FachriMFulchan/Arm_Manipulator_7_Functions/Dokumentasi/MainBoard_MasterController-removebg-preview.png

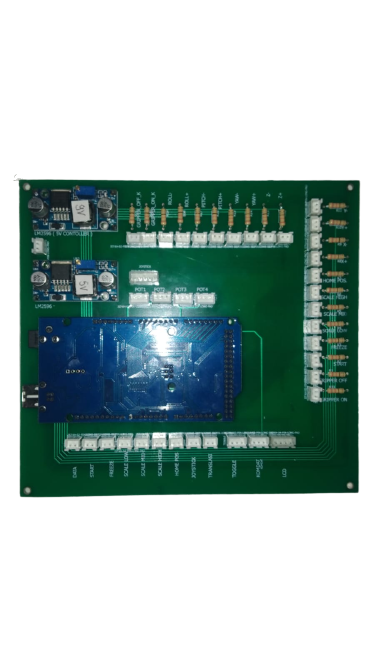
Dokumentasi/MainBoard_MasterController-removebg-preview.png
