FachriMFulchan/Arm_Manipulator_7_Functions/Master Controller/Elektrik/Skema Master Controller.jpeg

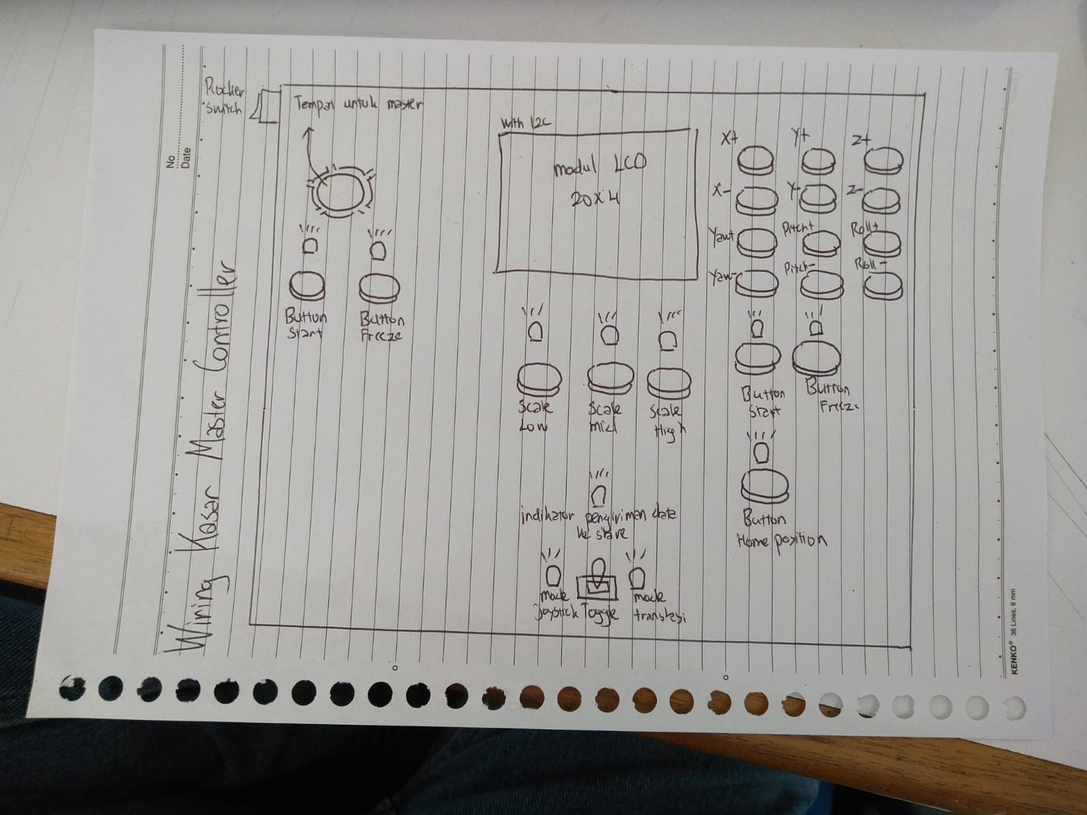
Master Controller/Elektrik/Skema Master Controller.jpeg
