FachriMFulchan/Arm_Manipulator_7_Functions/README.md

# Arm_Manipulator_7_Functions
Ini merupakan data dokumentasi dari Proyek Akhir kami yang berjudul "Rancang Bangun Arm Manipulator 7 Functions dan Master Controller" di Politeknik Manufaktur Negeri Bandung
