FachriMFulchan/Arm_Manipulator_7_Functions/Dokumentasi/driver.jpeg

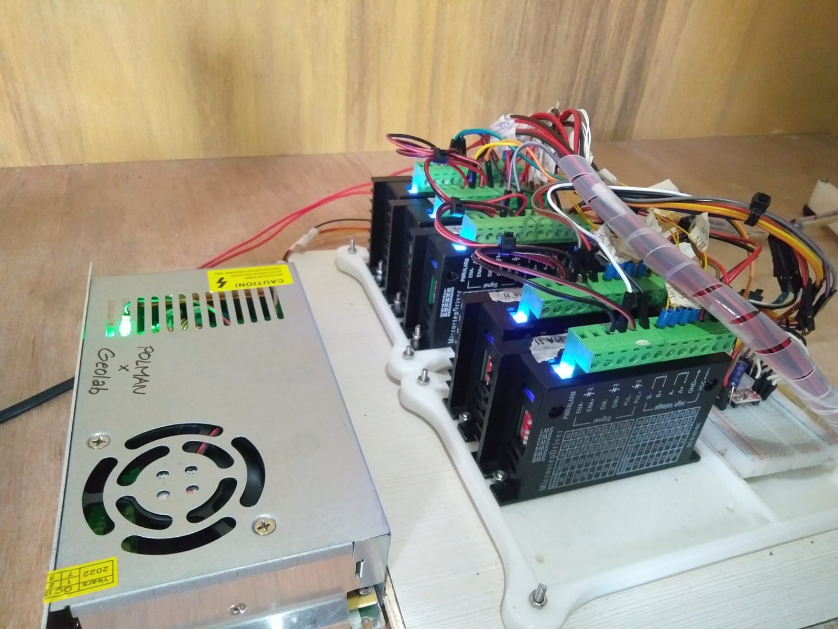
Dokumentasi/driver.jpeg
