FachriMFulchan/Arm_Manipulator_7_Functions/Dokumentasi/Joystick master 2.png

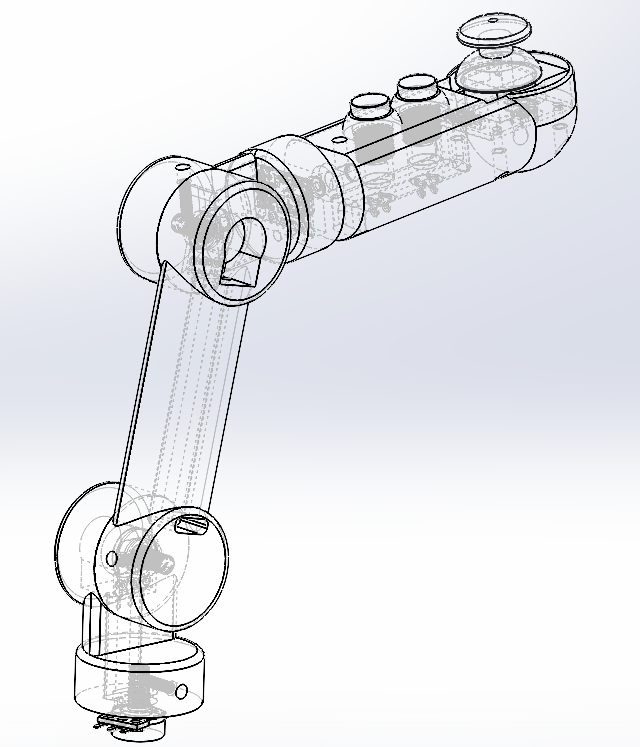
Dokumentasi/Joystick master 2.png
