FachriMFulchan/Arm_Manipulator_7_Functions/Dokumentasi/Manip.PNG

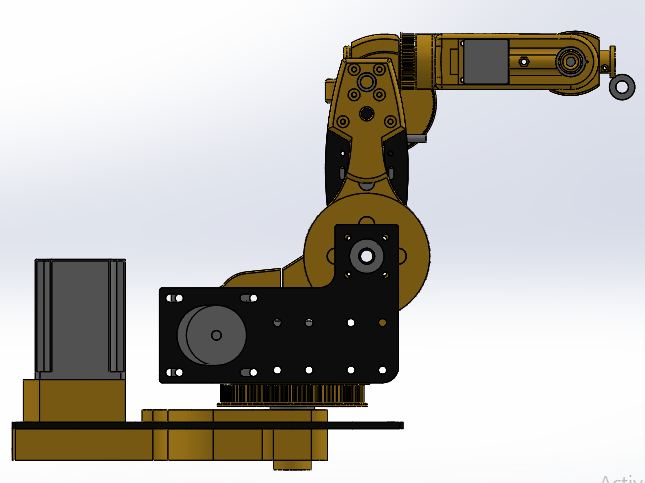
Dokumentasi/Manip.PNG
