FachriMFulchan/Arm_Manipulator_7_Functions/Dokumentasi/WhatsApp Image 2022-06-15 at 9.09.38 AM.jpeg

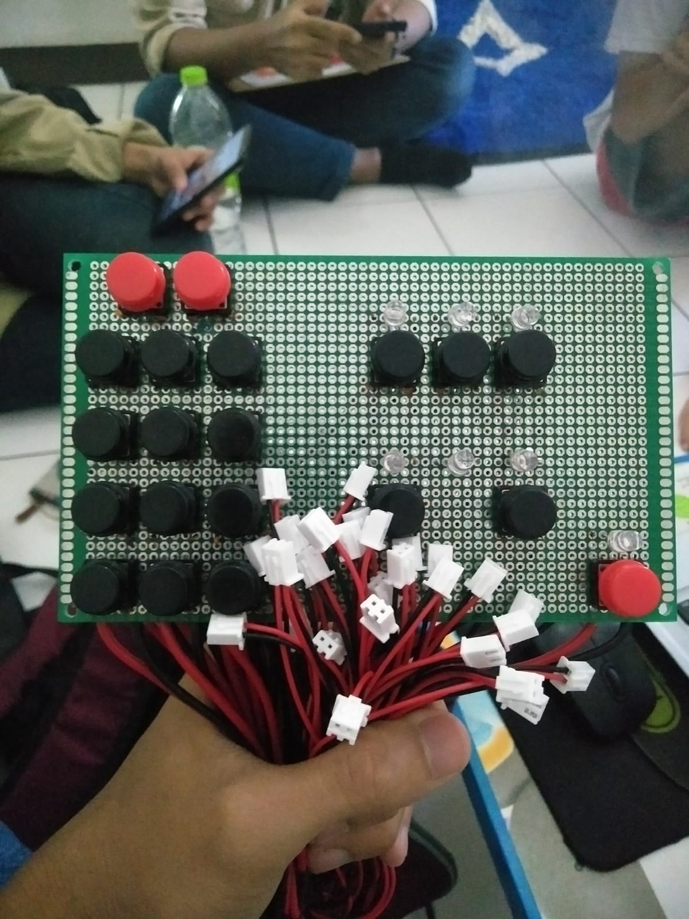
Dokumentasi/WhatsApp Image 2022-06-15 at 9.09.38 AM.jpeg
