FachriMFulchan/Arm_Manipulator_7_Functions/Dokumentasi/WhatsApp Image 2022-06-15 at 9.09.39 AM (1).jpeg

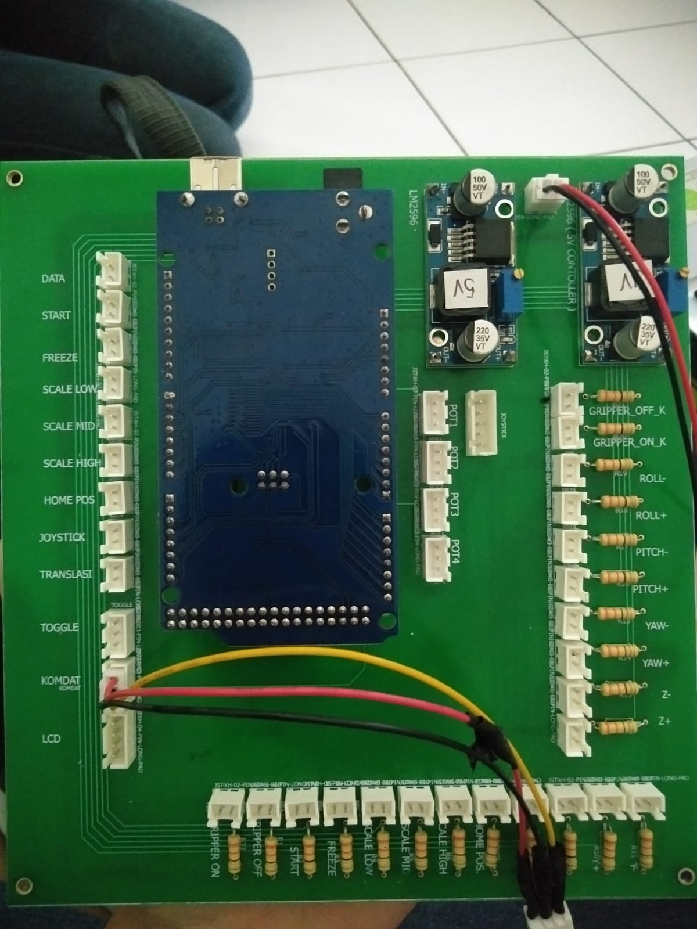
Dokumentasi/WhatsApp Image 2022-06-15 at 9.09.39 AM (1).jpeg
