FachriMFulchan/Arm_Manipulator_7_Functions/Dokumentasi/WhatsApp Image 2022-06-25 at 14.25.39.jpeg

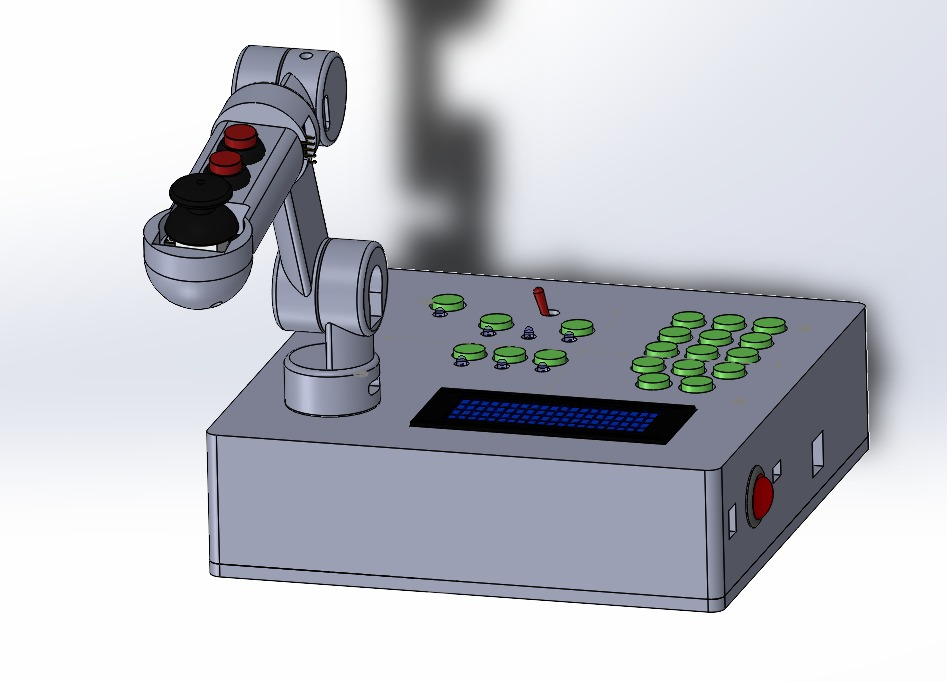
Dokumentasi/WhatsApp Image 2022-06-25 at 14.25.39.jpeg
