FachriMFulchan/Arm_Manipulator_7_Functions/Dokumentasi/WhatsApp Image 2022-07-04 at 04.54.05.jpeg

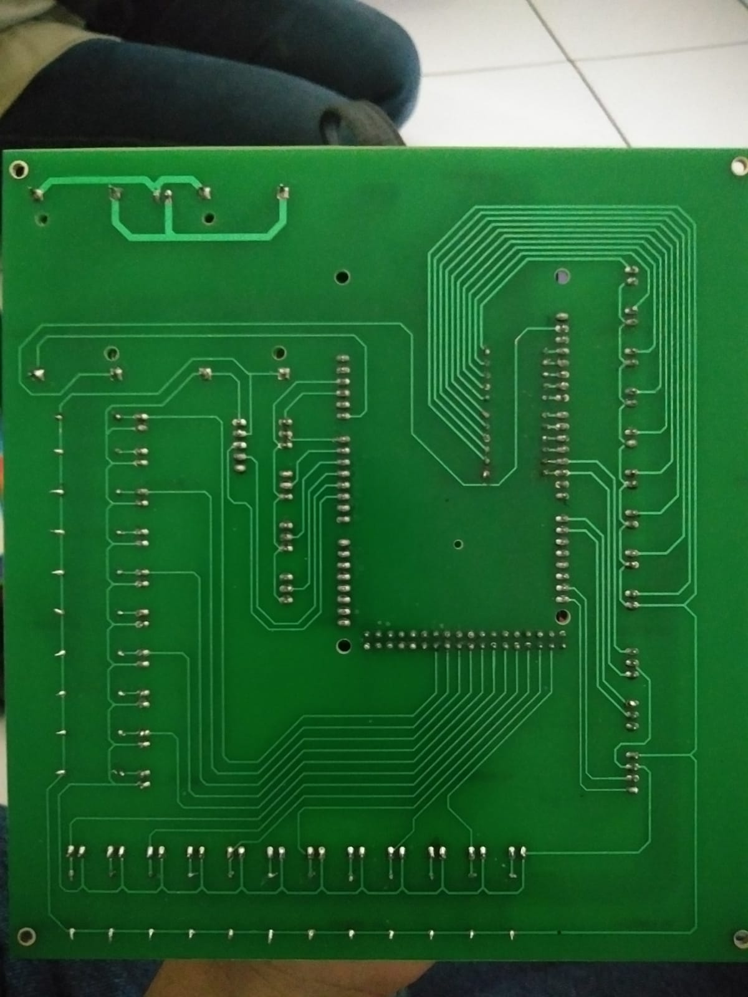
Dokumentasi/WhatsApp Image 2022-07-04 at 04.54.05.jpeg
