FachriMFulchan/Arm_Manipulator_7_Functions/Dokumentasi/WhatsApp Image 2022-07-06 at 9.26.13 AM.jpeg

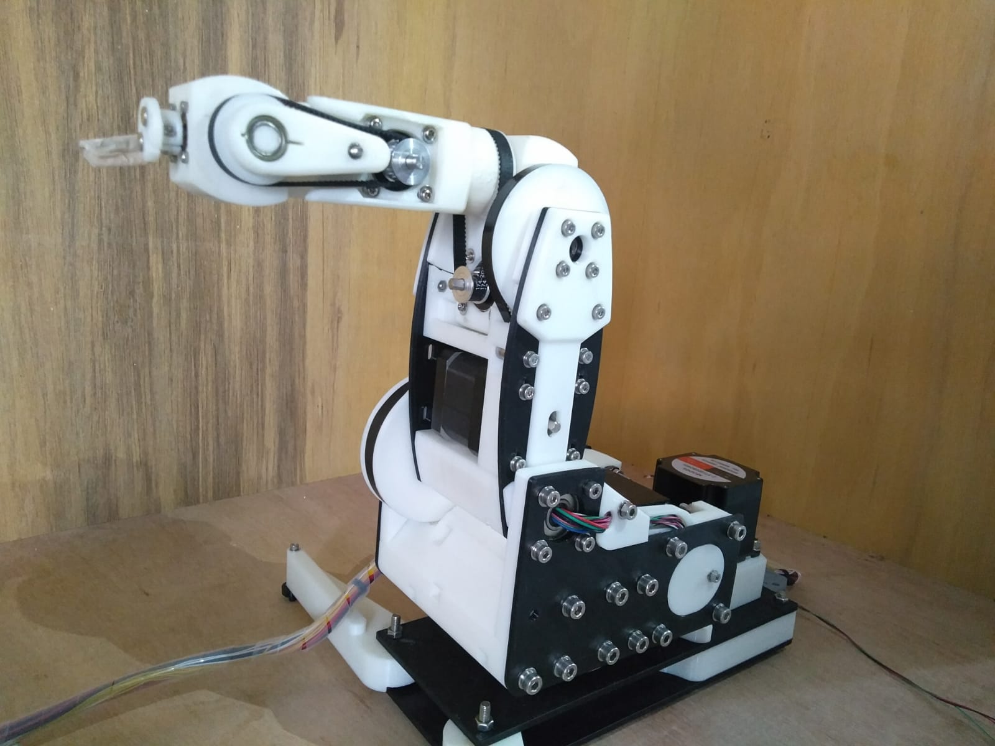
Dokumentasi/WhatsApp Image 2022-07-06 at 9.26.13 AM.jpeg
