FachriMFulchan/Arm_Manipulator_7_Functions/Dokumentasi/WhatsApp Image 2022-07-09 at 4.13.47 PM.jpeg

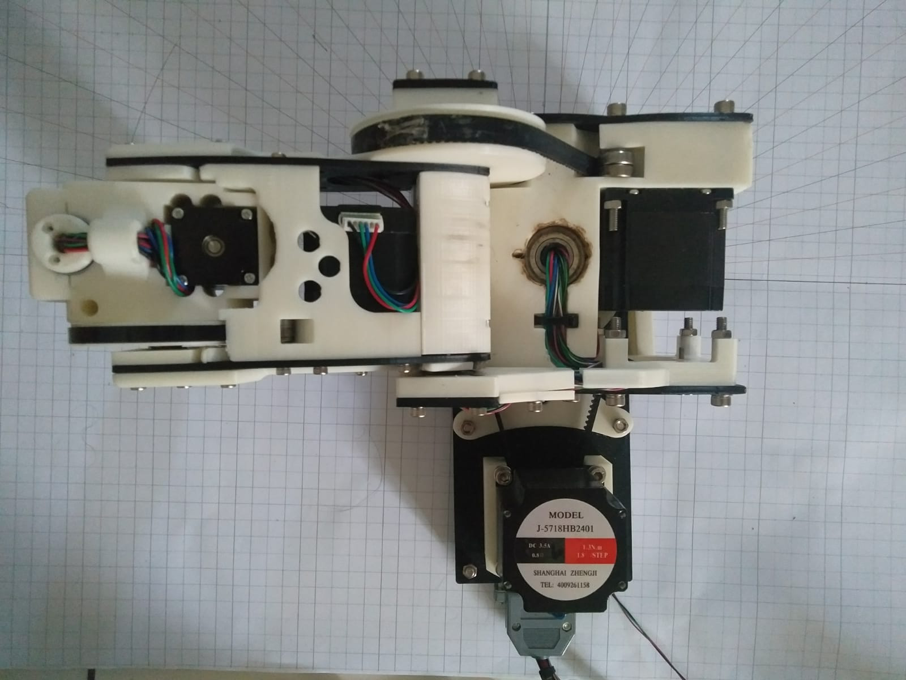
Dokumentasi/WhatsApp Image 2022-07-09 at 4.13.47 PM.jpeg
