FachriMFulchan/Arm_Manipulator_7_Functions/Dokumentasi/workspace1.PNG

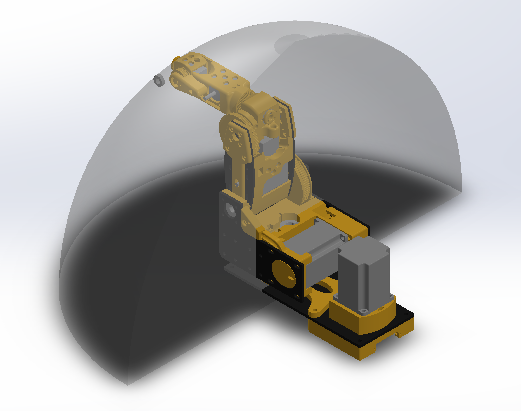
Dokumentasi/workspace1.PNG
