FachriMFulchan/Arm_Manipulator_7_Functions/Master Controller/Mekanik/SOLIDWORKS.Part/MasterV2 (40mm).SLDASM

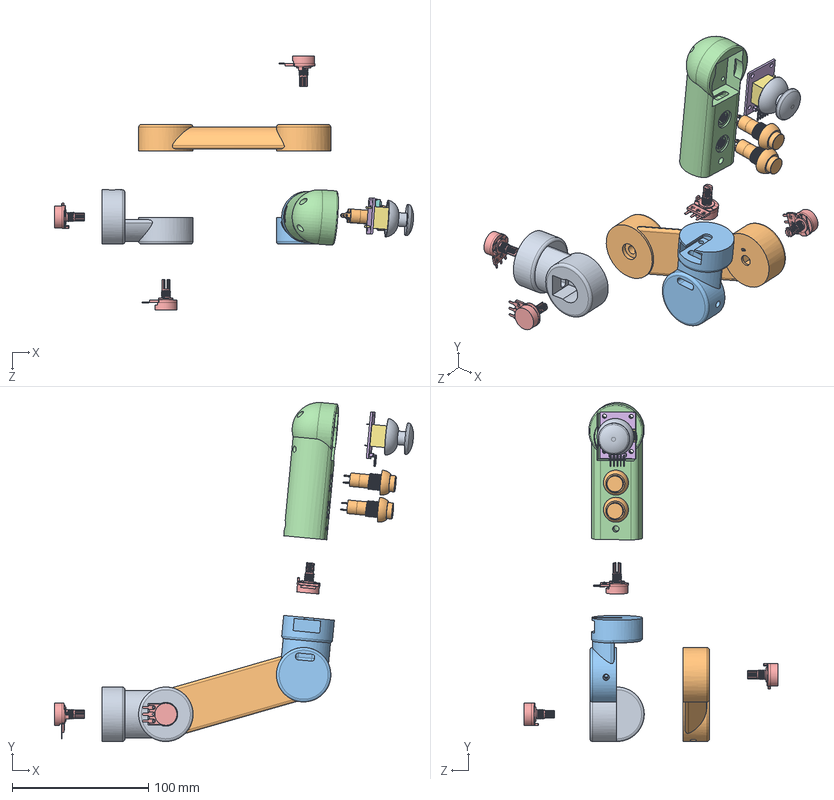
[picture p96: CAD file, 2022-08-14]
Master Controller/Mekanik/SOLIDWORKS.Part/MasterV2 (40mm).SLDASM
263.6 x 248.9 x 186.2 mm
Join1 (4mm)
Joint2 (4mm)
Joint3 (4mm)
Joint4 (4mm)
Potentiometer x 4
board
tactileswitch-short
joystickhead
pushButton x 2
