FachriMFulchan/Arm_Manipulator_7_Functions/Master Controller/Mekanik/SOLIDWORKS.Part/MasterV2.SLDASM

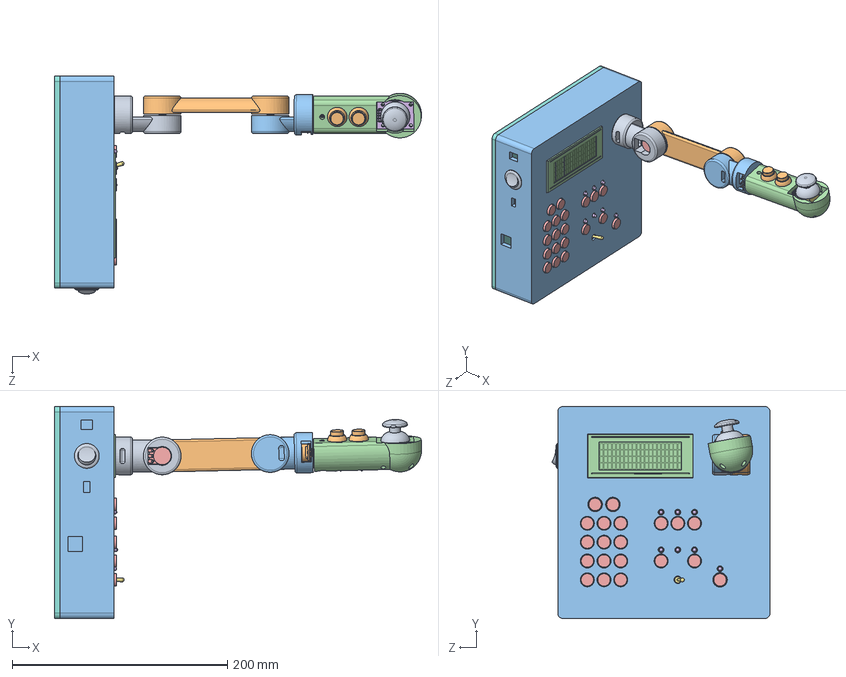
[picture p97: CAD file, 2022-08-14]
Master Controller/Mekanik/SOLIDWORKS.Part/MasterV2.SLDASM
340.6 x 197.0 x 202.4 mm
Join1
Joint2
Joint3
Joint4
Potentiometer x 3
board
tactileswitch-short
joystickhead
pushButton x 2
BASEV7
LCD 20x4 Display
Tactile Button Caps for B3F-4055 12X12X7.3MM x 20
THT LED green x 7
toggle switch
BOTTOM_BASE
Round Type Single Pole Rocker Switch
Potentiometer(1)
