FachriMFulchan/Arm_Manipulator_7_Functions/Arm Manipulator/Mekanik/Fusion360/Bersatu/scope_work.SLDPRT

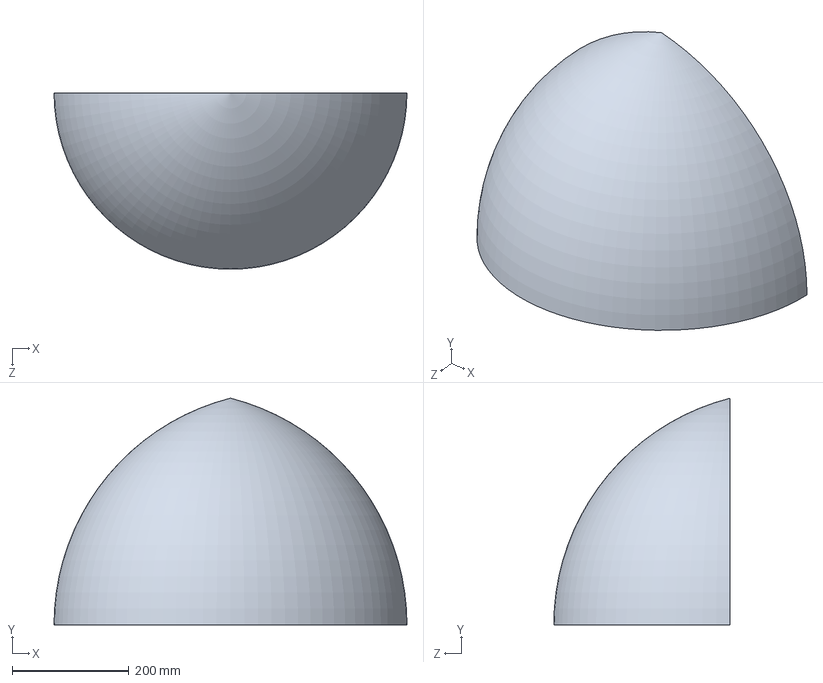
[picture p99: CAD file, 2022-07-10]
Arm Manipulator/Mekanik/Fusion360/Bersatu/scope_work.SLDPRT
605.0 x 388.5 x 302.5 mm
