FachriMFulchan/Arm_Manipulator_7_Functions/Arm Manipulator/Mekanik/STL/Axis5Bracket.stl

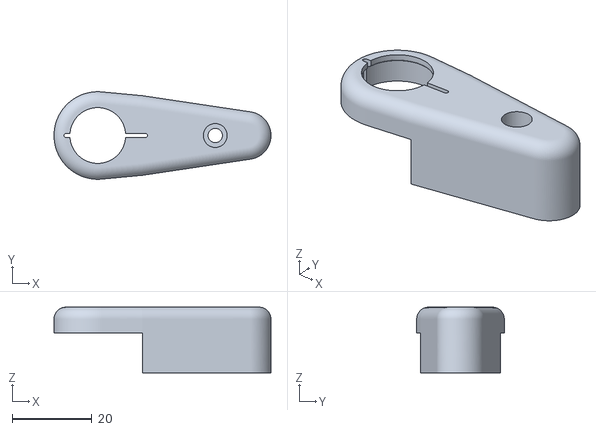
[picture p100: CAD file, 2022-07-10]
Arm Manipulator/Mekanik/STL/Axis5Bracket.stl
54.5 x 22.0 x 16.5
