FachriMFulchan/Arm_Manipulator_7_Functions/Master Controller/Mekanik/SOLIDWORKS.Part/RING2.SLDPRT

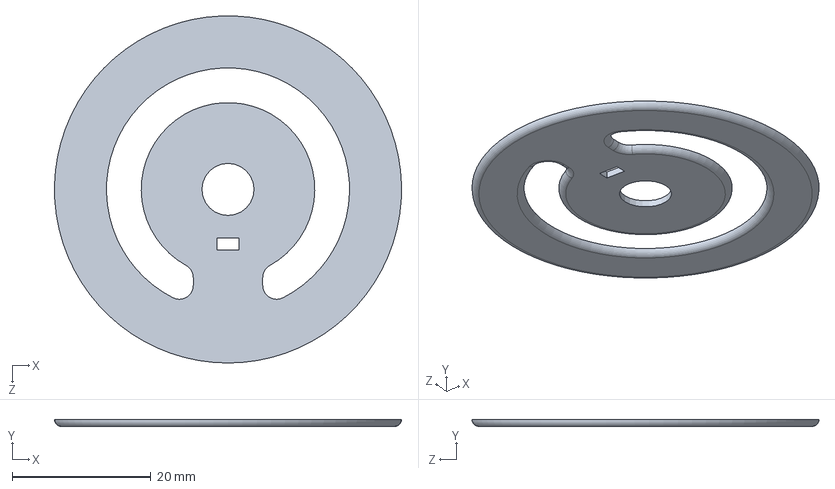
[picture p101: CAD file, 2022-08-14]
Master Controller/Mekanik/SOLIDWORKS.Part/RING2.SLDPRT
50.0 x 1.00 x 50.0 mm
