FachriMFulchan/Arm_Manipulator_7_Functions/Arm Manipulator/Mekanik/STL/Pulley56.stl

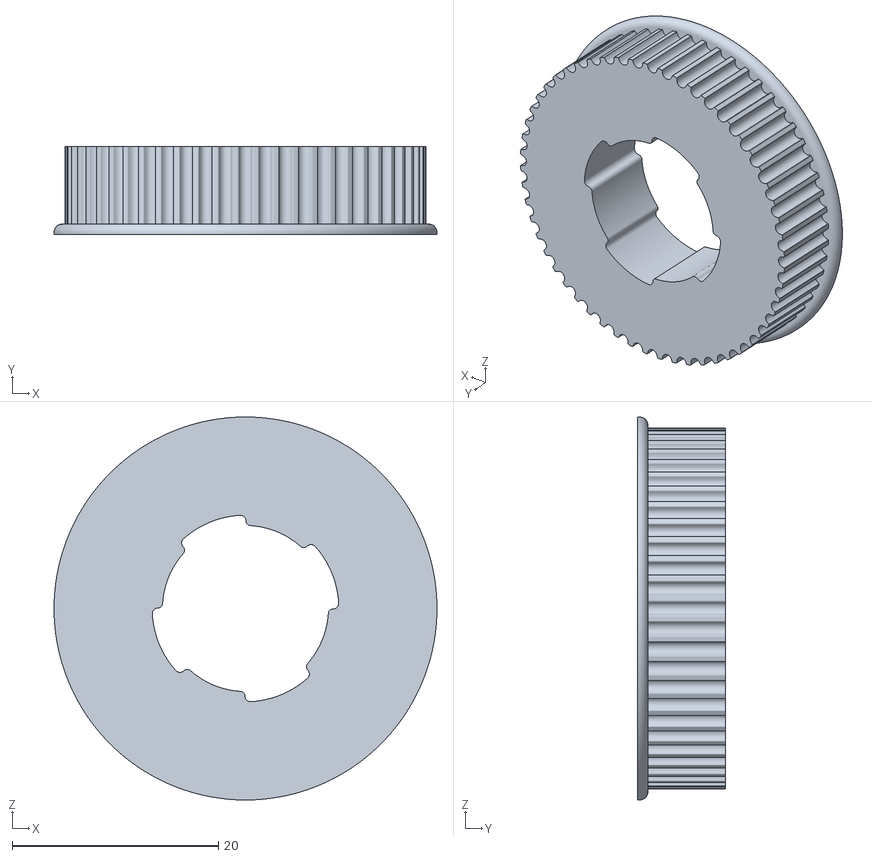
[picture p103: CAD file, 2022-07-10]
Arm Manipulator/Mekanik/STL/Pulley56.stl
37.1 x 8.50 x 37.1
