FachriMFulchan/Arm_Manipulator_7_Functions/Master Controller/Mekanik/SOLIDWORKS.Part/Joint2 (40mm) v4.SLDPRT

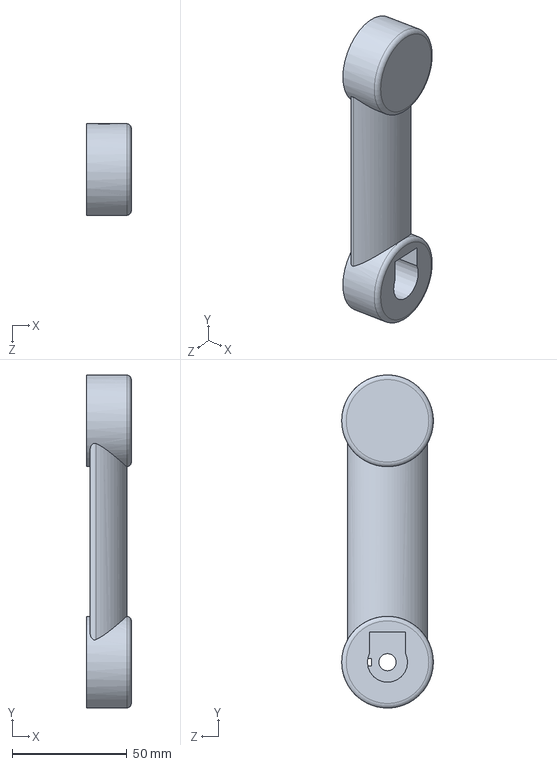
[picture p104: CAD file, 2022-08-14]
Master Controller/Mekanik/SOLIDWORKS.Part/Joint2 (40mm) v4.SLDPRT
19.5 x 145.2 x 40.0 mm
