FachriMFulchan/Arm_Manipulator_7_Functions/Arm Manipulator/Mekanik/Fusion360/Axis6 v13.step

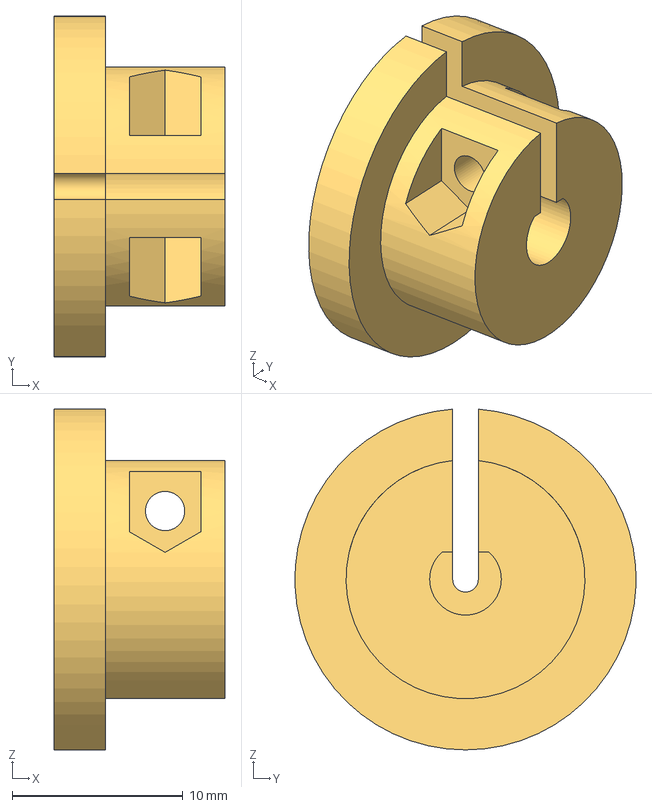
[picture p105: CAD file, 2022-07-10]
Arm Manipulator/Mekanik/Fusion360/Axis6 v13.step
10.0 x 20.0 x 20.0 mm
