FachriMFulchan/Arm_Manipulator_7_Functions/Master Controller/Mekanik/SOLIDWORKS.Part/RING.SLDPRT

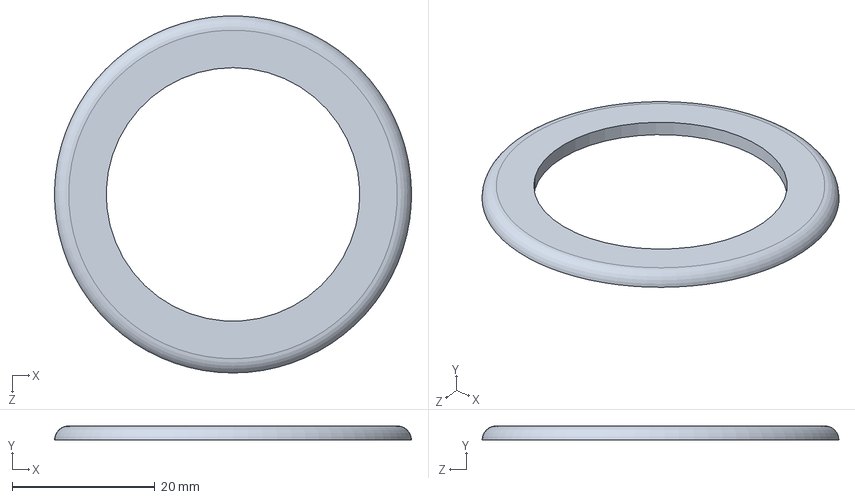
[picture p106: CAD file, 2022-08-14]
Master Controller/Mekanik/SOLIDWORKS.Part/RING.SLDPRT
50.0 x 2.00 x 50.0 mm
