FachriMFulchan/Arm_Manipulator_7_Functions/Arm Manipulator/Mekanik/STL/Axis3cover1.stl

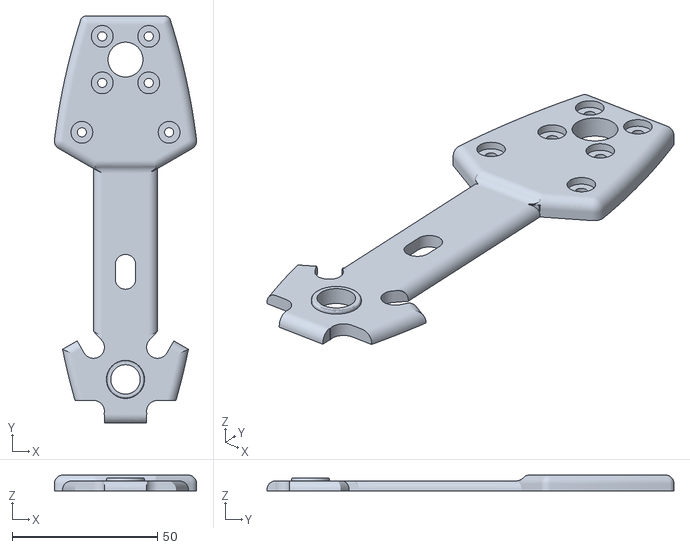
[picture p107: CAD file, 2022-07-10]
Arm Manipulator/Mekanik/STL/Axis3cover1.stl
48.9 x 140.0 x 5.50
