FachriMFulchan/Arm_Manipulator_7_Functions/Master Controller/Mekanik/SOLIDWORKS.Part/Joint4 (40mm).SLDPRT

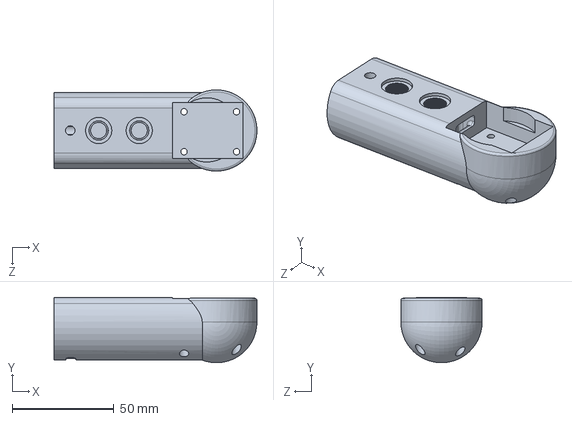
[picture p108: CAD file, 2022-08-14]
Master Controller/Mekanik/SOLIDWORKS.Part/Joint4 (40mm).SLDPRT
100.0 x 32.2 x 40.0 mm
