FachriMFulchan/Arm_Manipulator_7_Functions/Arm Manipulator/Mekanik/STL/Axis2bearingHC.stl

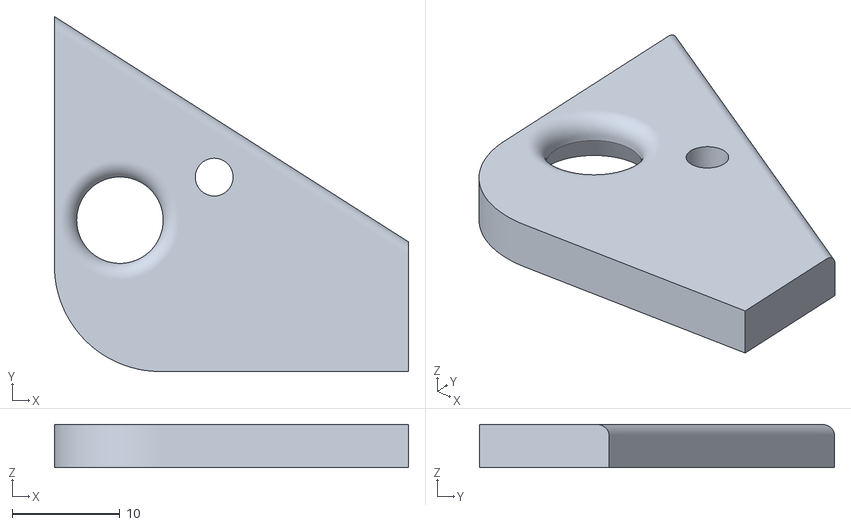
[picture p109: CAD file, 2022-07-10]
Arm Manipulator/Mekanik/STL/Axis2bearingHC.stl
32.8 x 32.9 x 4.00
