FachriMFulchan/Arm_Manipulator_7_Functions/Master Controller/Mekanik/SOLIDWORKS.Part/Join1 (40mm)  v4.SLDPRT

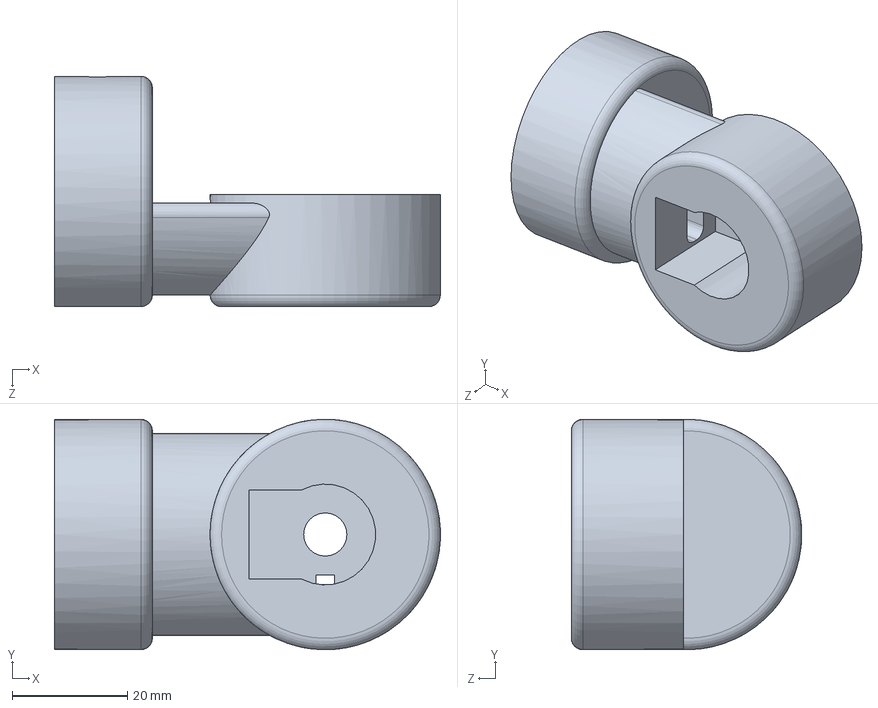
[picture p110: CAD file, 2022-08-14]
Master Controller/Mekanik/SOLIDWORKS.Part/Join1 (40mm) v4.SLDPRT
67.0 x 40.0 x 40.0 mm
