FachriMFulchan/Arm_Manipulator_7_Functions/Arm Manipulator/Mekanik/STL/Axis2bearingHolder.stl

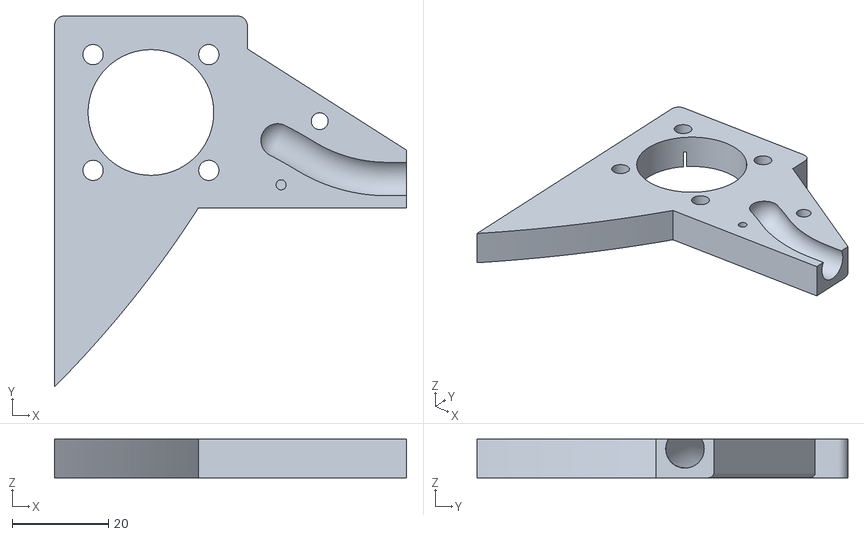
[picture p111: CAD file, 2022-07-10]
Arm Manipulator/Mekanik/STL/Axis2bearingHolder.stl
73.0 x 76.9 x 8.00
