FachriMFulchan/Arm_Manipulator_7_Functions/Master Controller/Mekanik/SOLIDWORKS.Part/BOTTOM_BASE.SLDPRT

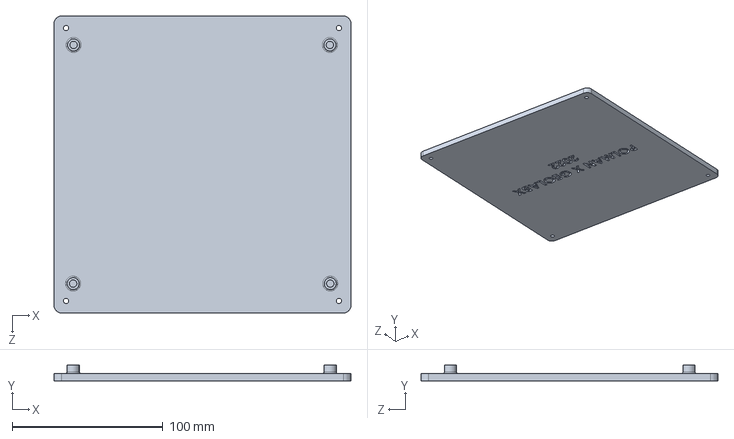
[picture p112: CAD file, 2022-08-14]
Master Controller/Mekanik/SOLIDWORKS.Part/BOTTOM_BASE.SLDPRT
197.0 x 10.5 x 197.0 mm
