FachriMFulchan/Arm_Manipulator_7_Functions/Arm Manipulator/Mekanik/STL/Axis1MotorHolder.stl

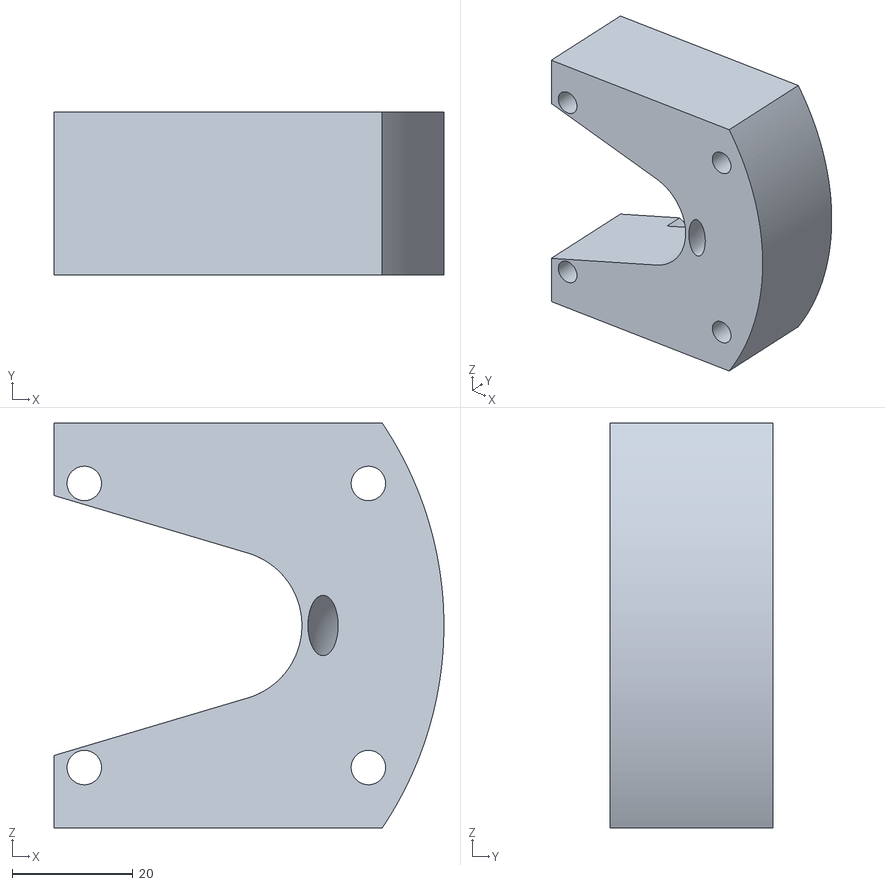
[picture p113: CAD file, 2022-07-10]
Arm Manipulator/Mekanik/STL/Axis1MotorHolder.stl
64.5 x 27.0 x 67.0
