FachriMFulchan/Arm_Manipulator_7_Functions/Master Controller/Mekanik/SOLIDWORKS.Part/Joint3 (40mm) v4.SLDPRT

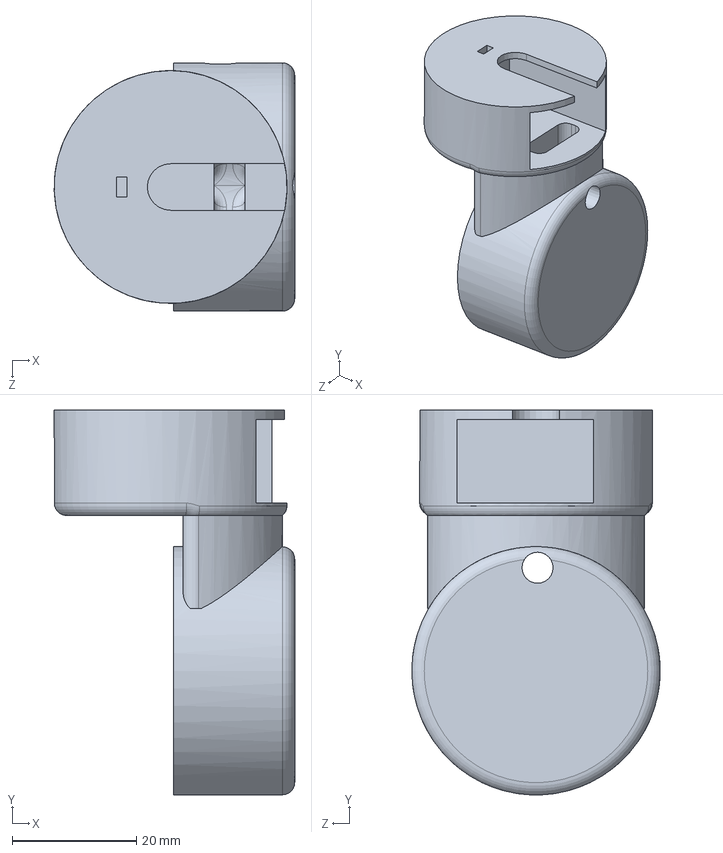
[picture p114: CAD file, 2022-08-14]
Master Controller/Mekanik/SOLIDWORKS.Part/Joint3 (40mm) v4.SLDPRT
38.7 x 62.0 x 40.0 mm
