FachriMFulchan/Arm_Manipulator_7_Functions/Arm Manipulator/Mekanik/STL/Axis2MotorOp.stl

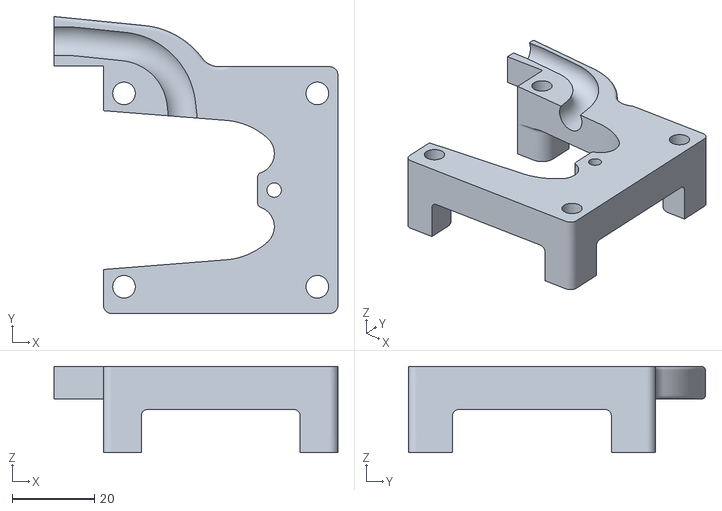
[picture p115: CAD file, 2022-07-10]
Arm Manipulator/Mekanik/STL/Axis2MotorOp.stl
69.0 x 72.2 x 21.0
