FachriMFulchan/Arm_Manipulator_7_Functions/Arm Manipulator/Mekanik/STL/Axis3part3.stl

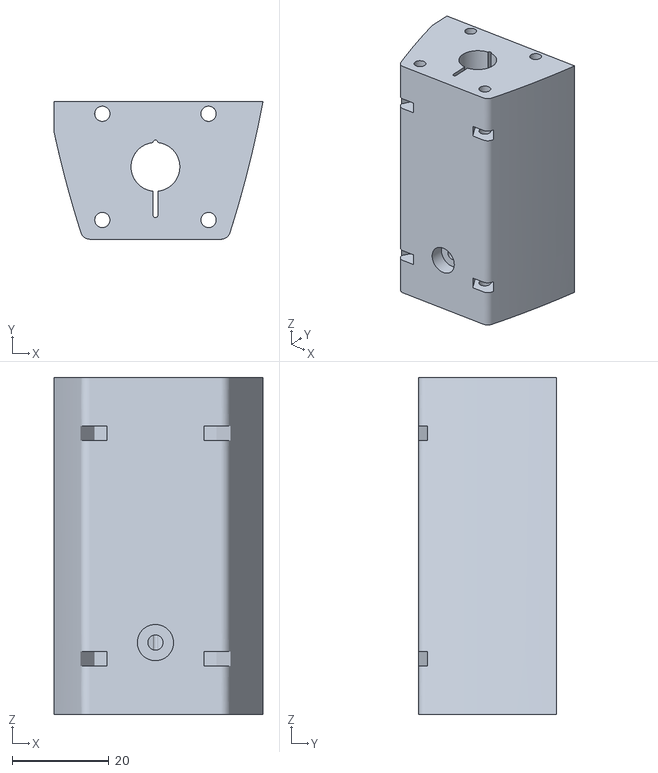
[picture p116: CAD file, 2022-07-10]
Arm Manipulator/Mekanik/STL/Axis3part3.stl
43.3 x 28.5 x 69.8
