FachriMFulchan/Arm_Manipulator_7_Functions/Arm Manipulator/Mekanik/STL/Axis5plug.stl

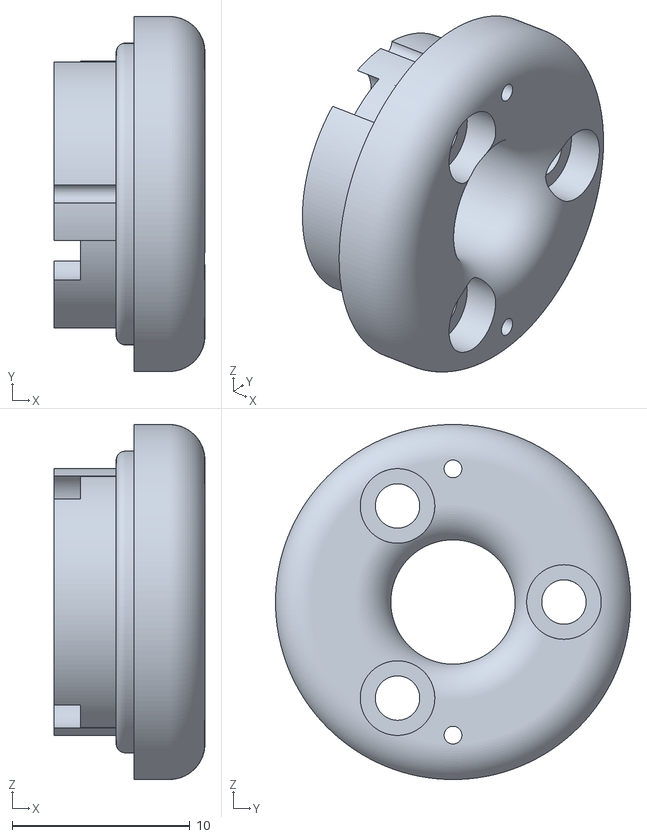
[picture p117: CAD file, 2022-07-10]
Arm Manipulator/Mekanik/STL/Axis5plug.stl
8.50 x 20.0 x 20.0
