FachriMFulchan/Arm_Manipulator_7_Functions/Master Controller/Mekanik/SOLIDWORKS.Part/BASEV7.SLDPRT

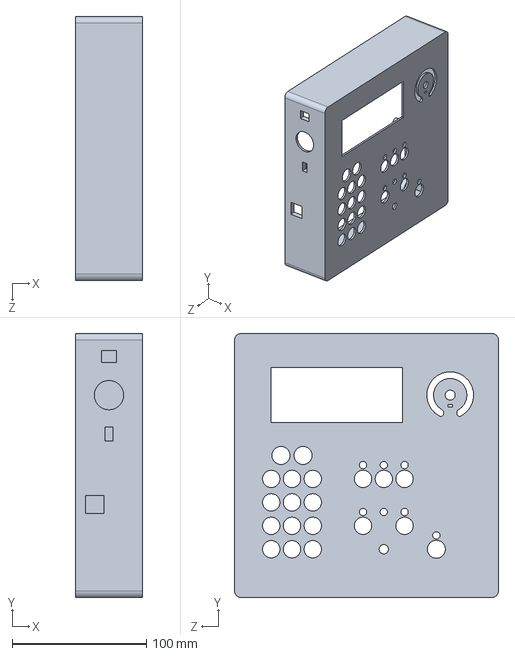
[picture p118: CAD file, 2022-08-14]
Master Controller/Mekanik/SOLIDWORKS.Part/BASEV7.SLDPRT
50.0 x 197.0 x 197.0 mm
