FachriMFulchan/Arm_Manipulator_7_Functions/Arm Manipulator/Mekanik/STL/Pulley42.stl

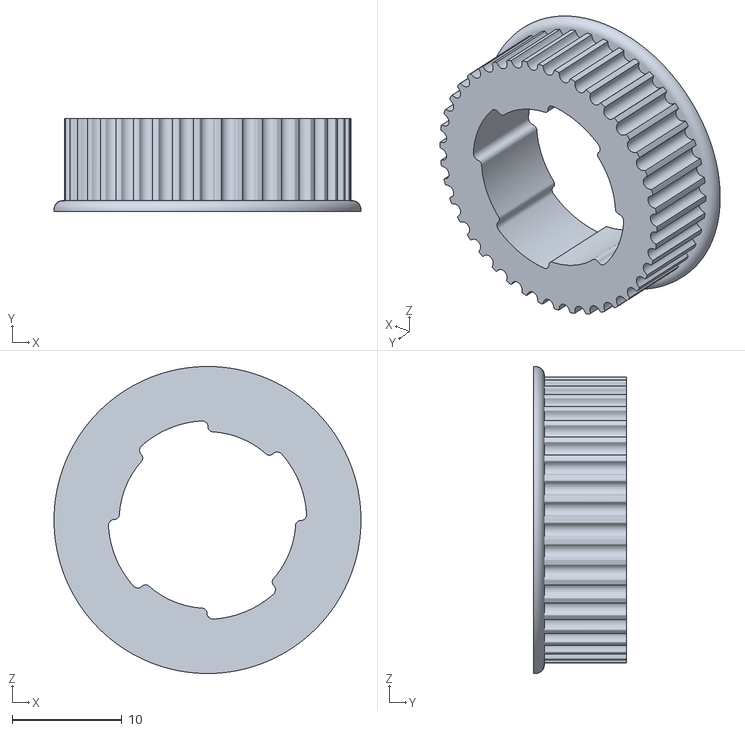
[picture p119: CAD file, 2022-07-10]
Arm Manipulator/Mekanik/STL/Pulley42.stl
28.0 x 8.50 x 28.0
