FachriMFulchan/Arm_Manipulator_7_Functions/Arm Manipulator/Mekanik/STL/Electronics.stl

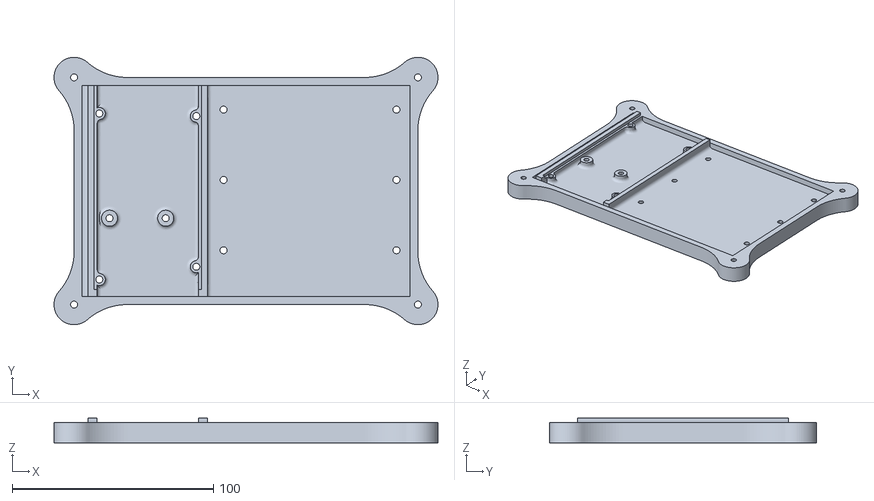
[picture p120: CAD file, 2022-07-10]
Arm Manipulator/Mekanik/STL/Electronics.stl
191.0 x 133.0 x 12.2
