FachriMFulchan/Arm_Manipulator_7_Functions/Arm Manipulator/Mekanik/STL/Axis6.stl

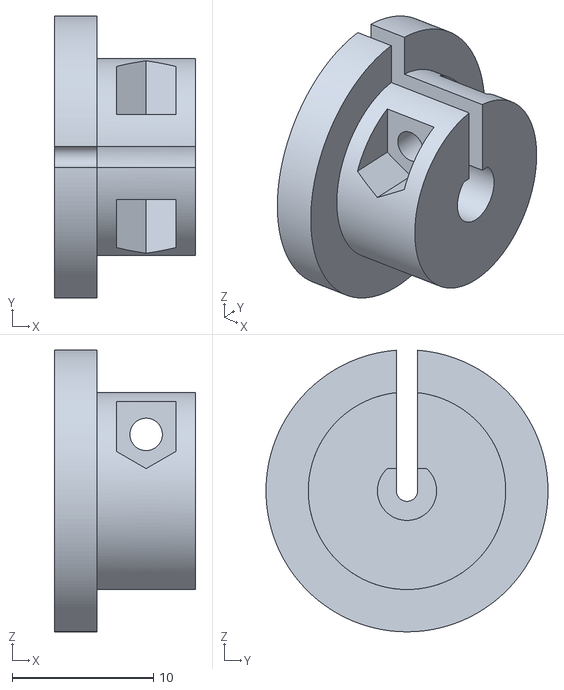
[picture p121: CAD file, 2022-07-10]
Arm Manipulator/Mekanik/STL/Axis6.stl
10.0 x 20.0 x 20.0
