FachriMFulchan/Arm_Manipulator_7_Functions/Arm Manipulator/Mekanik/STL/Axis3cover2.stl

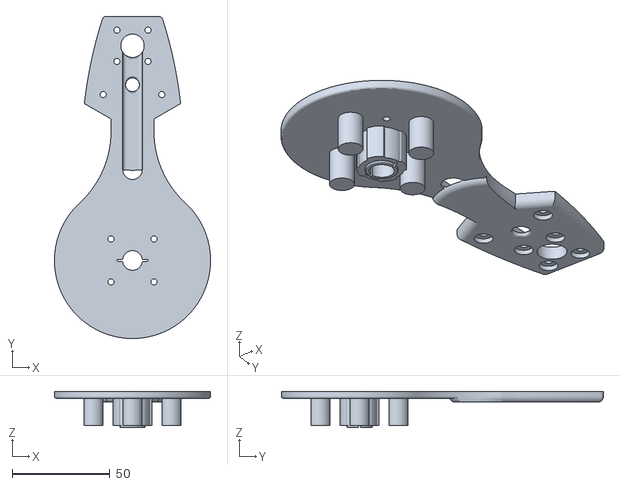
[picture p122: CAD file, 2022-07-10]
Arm Manipulator/Mekanik/STL/Axis3cover2.stl
80.0 x 165.0 x 18.5
