FachriMFulchan/Arm_Manipulator_7_Functions/Arm Manipulator/Mekanik/STL/Axis2part2.stl

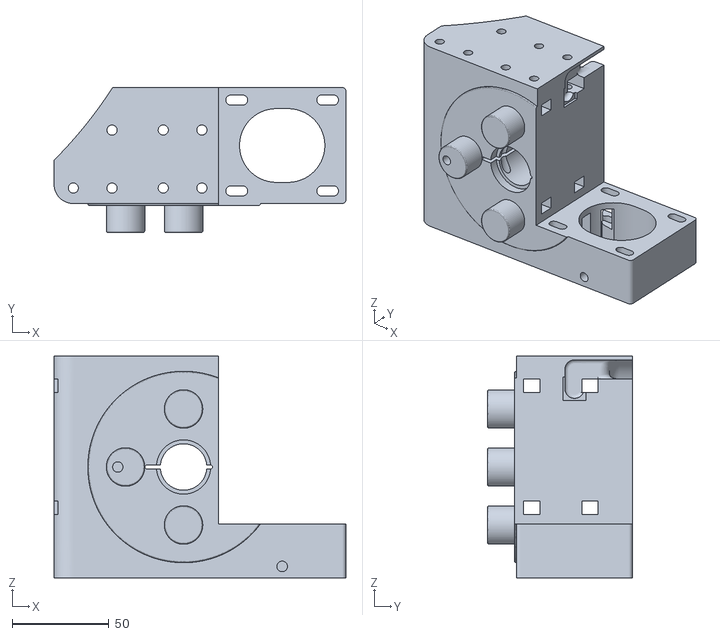
[picture p123: CAD file, 2022-07-10]
Arm Manipulator/Mekanik/STL/Axis2part2.stl
151.0 x 75.0 x 114.8
