FachriMFulchan/Arm_Manipulator_7_Functions/Arm Manipulator/Mekanik/STL/Axis2MotorOpC.stl

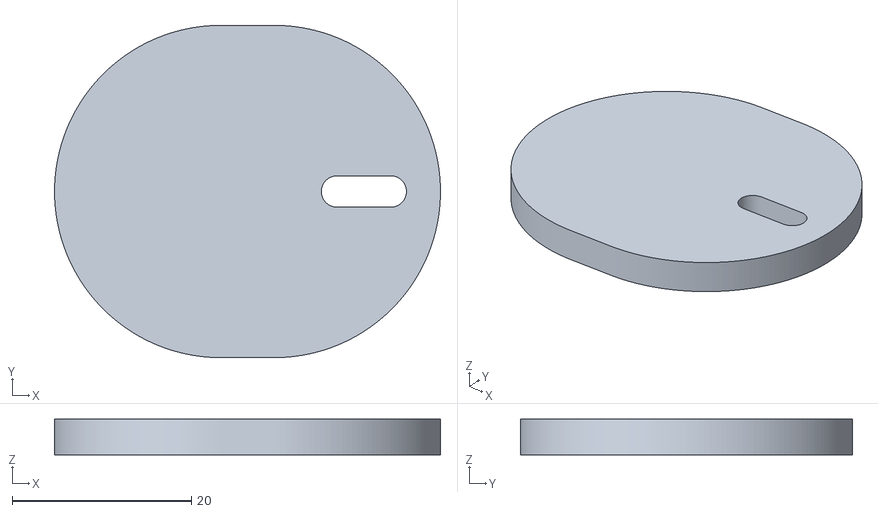
[picture p124: CAD file, 2022-07-10]
Arm Manipulator/Mekanik/STL/Axis2MotorOpC.stl
43.1 x 37.1 x 4.00
