FachriMFulchan/Arm_Manipulator_7_Functions/Arm Manipulator/Mekanik/STL/Axis5.stl

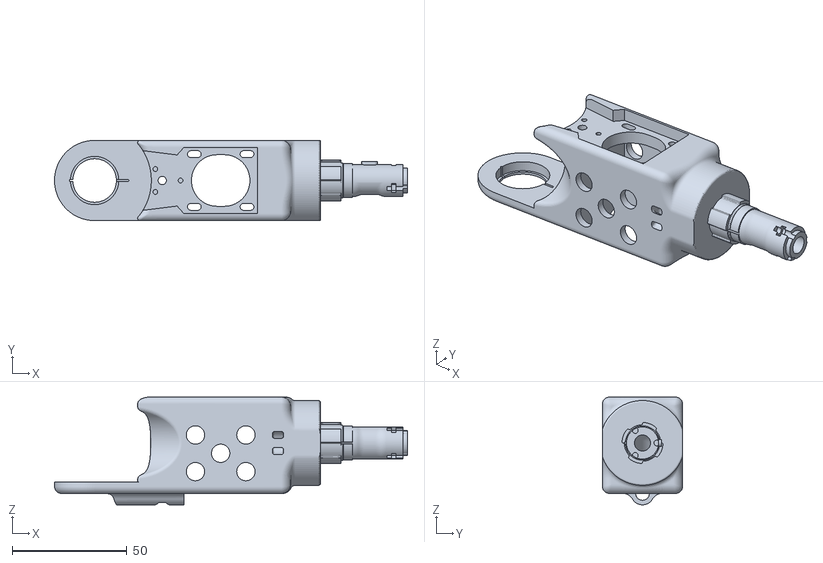
[picture p125: CAD file, 2022-07-10]
Arm Manipulator/Mekanik/STL/Axis5.stl
154.0 x 35.0 x 47.0
