FachriMFulchan/Arm_Manipulator_7_Functions/Arm Manipulator/Mekanik/STL/Axis3part2.stl

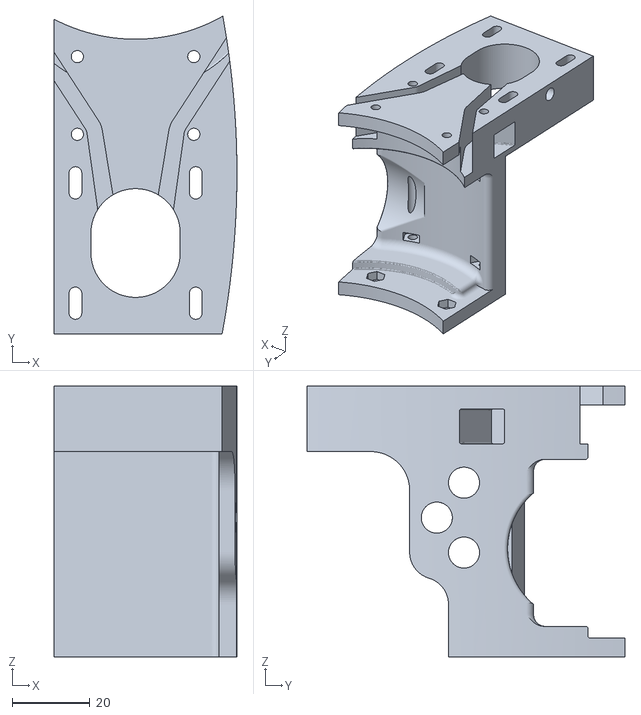
[picture p126: CAD file, 2022-07-10]
Arm Manipulator/Mekanik/STL/Axis3part2.stl
47.1 x 81.8 x 69.8
