FachriMFulchan/Arm_Manipulator_7_Functions/Arm Manipulator/Mekanik/STL/Axis3bearingHolder.stl

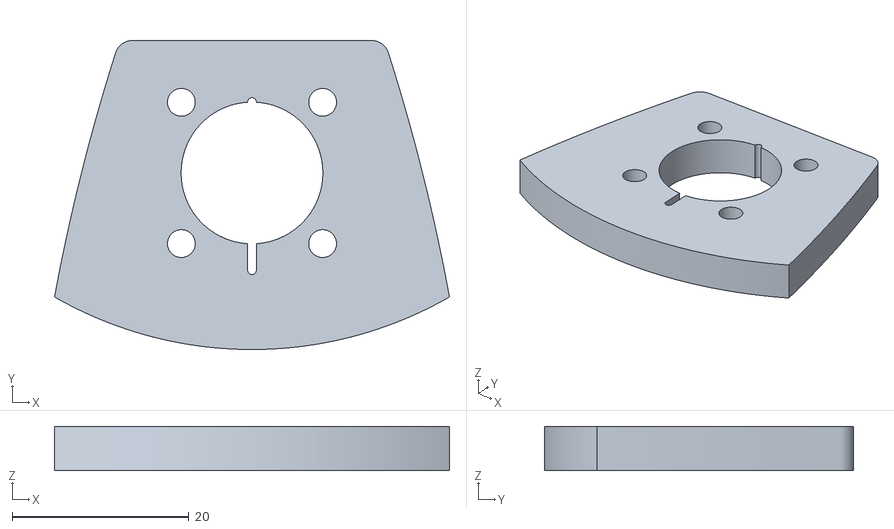
[picture p127: CAD file, 2022-07-10]
Arm Manipulator/Mekanik/STL/Axis3bearingHolder.stl
44.7 x 35.0 x 5.00
