FachriMFulchan/Arm_Manipulator_7_Functions/Arm Manipulator/Mekanik/STL/LegLeft.stl

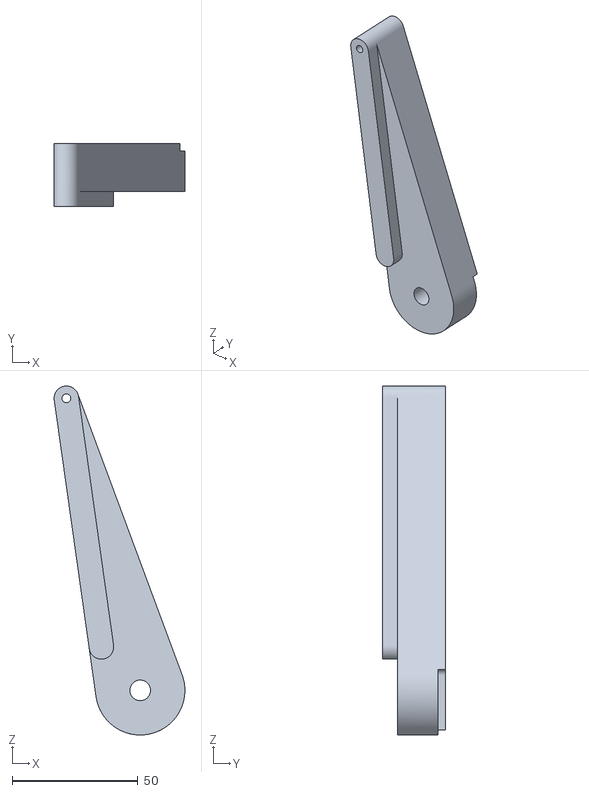
[picture p128: CAD file, 2022-07-10]
Arm Manipulator/Mekanik/STL/LegLeft.stl
52.1 x 25.0 x 139.0
