FachriMFulchan/Arm_Manipulator_7_Functions/Arm Manipulator/Mekanik/STL/Axis3part1.stl

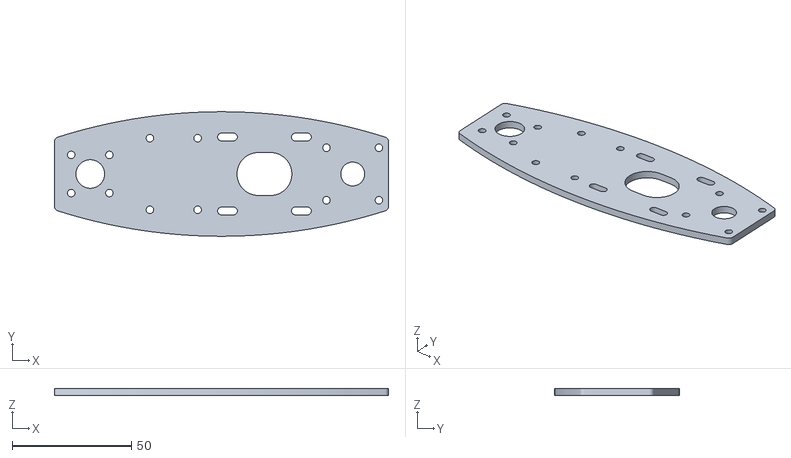
[picture p129: CAD file, 2022-07-10]
Arm Manipulator/Mekanik/STL/Axis3part1.stl
140.0 x 52.2 x 3.00
