FachriMFulchan/Arm_Manipulator_7_Functions/Arm Manipulator/Mekanik/STL/Cover.stl

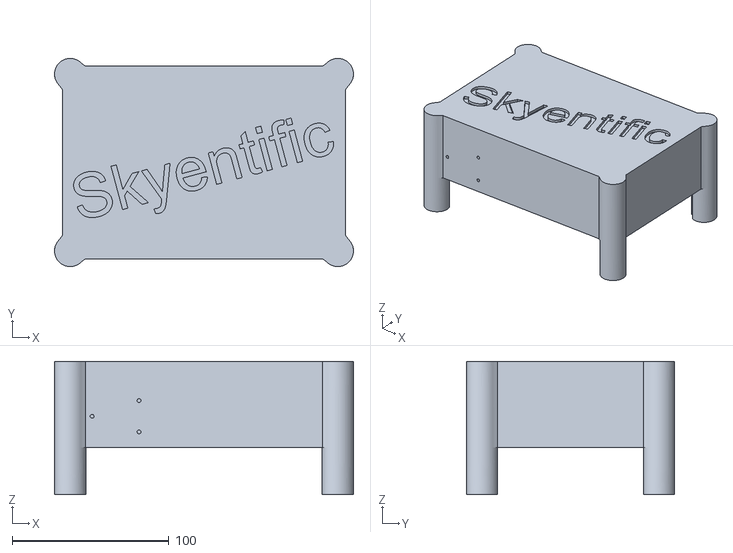
[picture p130: CAD file, 2022-07-10]
Arm Manipulator/Mekanik/STL/Cover.stl
191.0 x 133.0 x 85.0
