FachriMFulchan/Arm_Manipulator_7_Functions/Arm Manipulator/Mekanik/STL/Axis4limit.stl

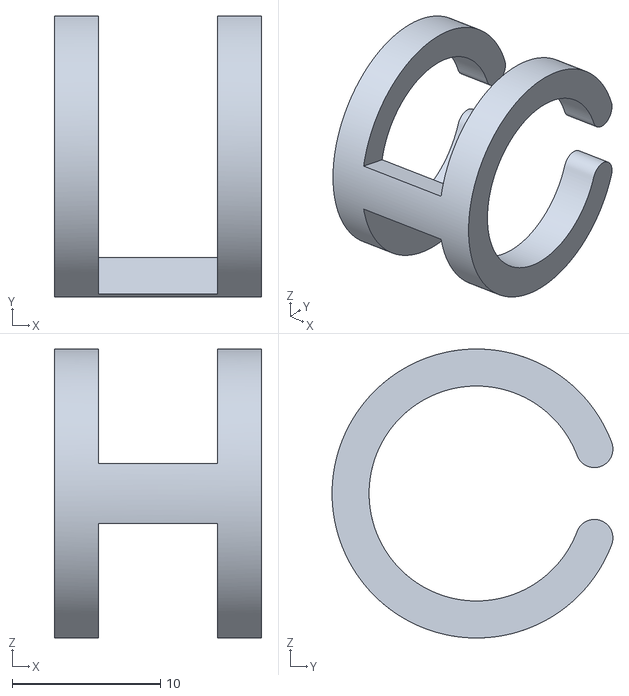
[picture p131: CAD file, 2022-07-10]
Arm Manipulator/Mekanik/STL/Axis4limit.stl
14.0 x 19.0 x 19.5
