FachriMFulchan/Arm_Manipulator_7_Functions/Arm Manipulator/Mekanik/STL/Axis1Pulley.stl

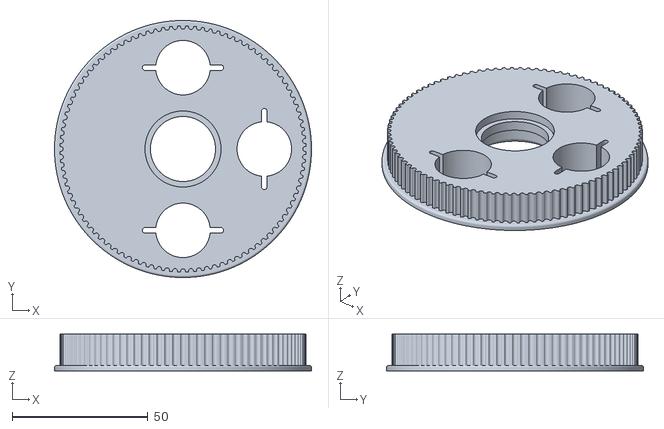
[picture p132: CAD file, 2022-07-10]
Arm Manipulator/Mekanik/STL/Axis1Pulley.stl
94.8 x 94.8 x 13.5
