FachriMFulchan/Arm_Manipulator_7_Functions/Arm Manipulator/Mekanik/STL/Axis1MotorHolderOp.stl

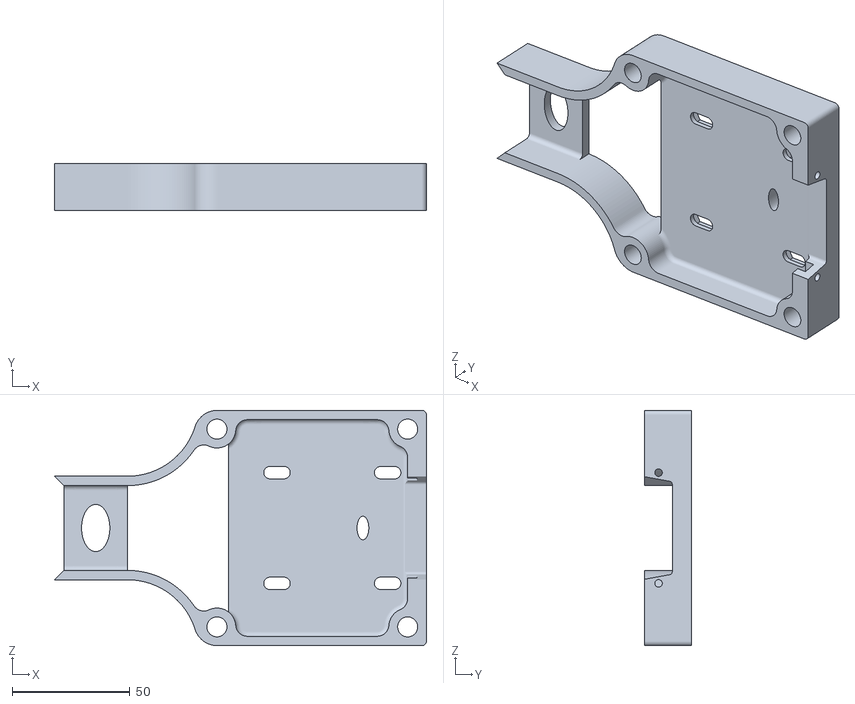
[picture p133: CAD file, 2022-07-10]
Arm Manipulator/Mekanik/STL/Axis1MotorHolderOp.stl
158.0 x 20.0 x 100.0
