FachriMFulchan/Arm_Manipulator_7_Functions/Arm Manipulator/Mekanik/STL/Axis2Pulley.stl

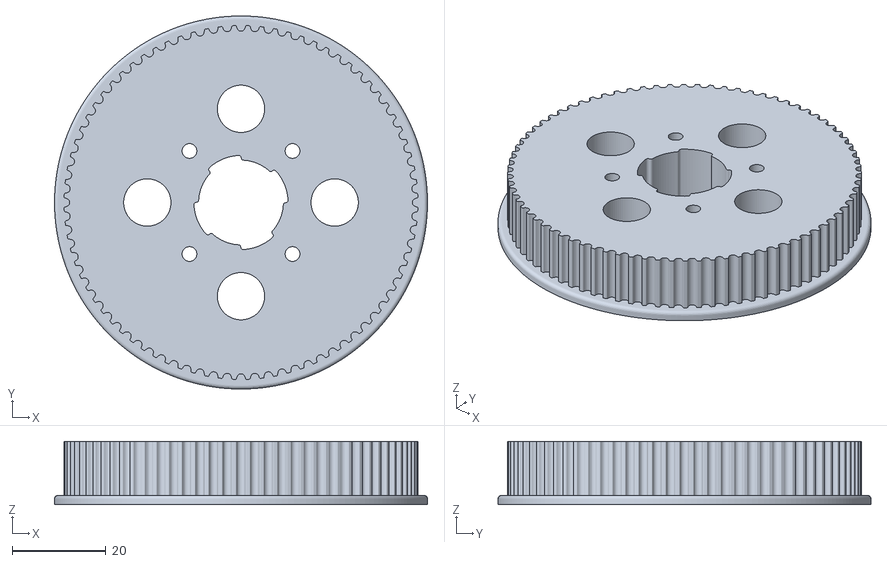
[picture p134: CAD file, 2022-07-10]
Arm Manipulator/Mekanik/STL/Axis2Pulley.stl
79.6 x 79.6 x 13.5
