FachriMFulchan/Arm_Manipulator_7_Functions/Arm Manipulator/Mekanik/STL/Axis2part1.stl

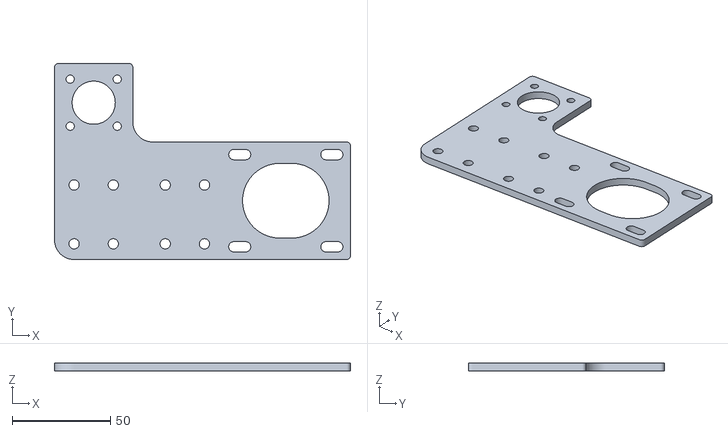
[picture p135: CAD file, 2022-07-10]
Arm Manipulator/Mekanik/STL/Axis2part1.stl
151.0 x 100.0 x 4.00
