FachriMFulchan/Arm_Manipulator_7_Functions/Arm Manipulator/Mekanik/STL/Axis1part2.stl

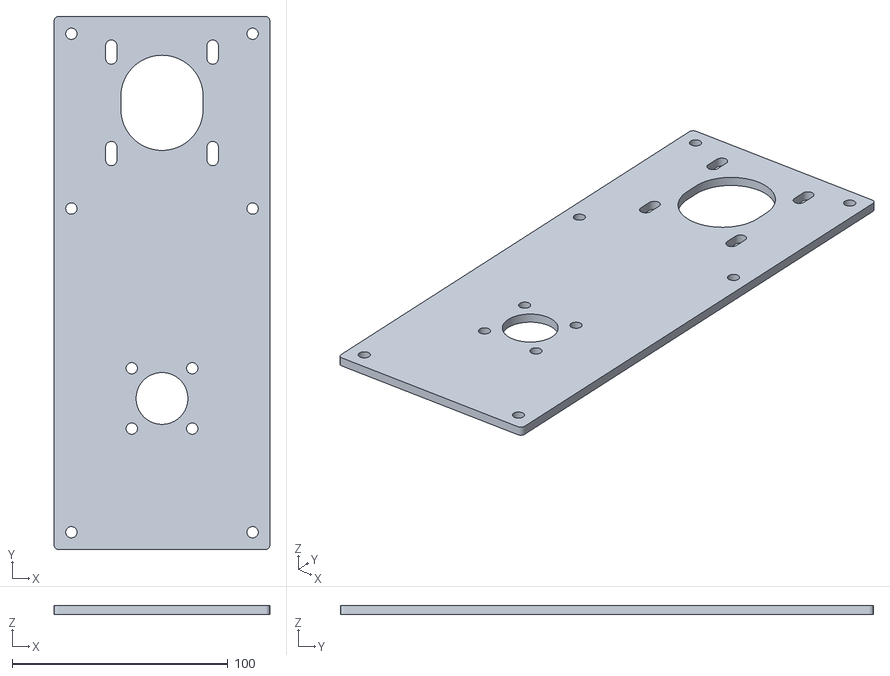
[picture p136: CAD file, 2022-07-10]
Arm Manipulator/Mekanik/STL/Axis1part2.stl
100.0 x 247.0 x 4.00
