FachriMFulchan/Arm_Manipulator_7_Functions/Arm Manipulator/Mekanik/STL/FootHolder.stl

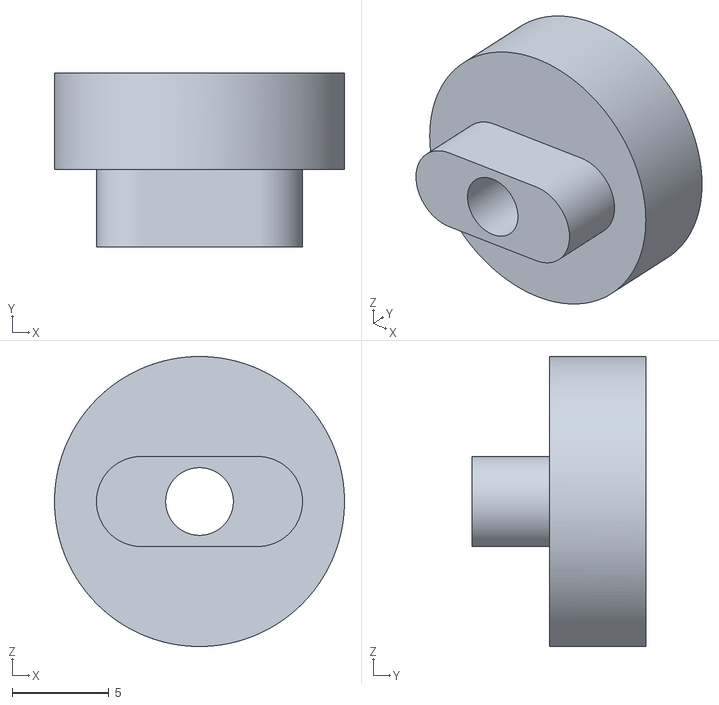
[picture p137: CAD file, 2022-07-10]
Arm Manipulator/Mekanik/STL/FootHolder.stl
15.0 x 9.00 x 15.0
