FachriMFulchan/Arm_Manipulator_7_Functions/Arm Manipulator/Mekanik/STL/Pulley100.stl

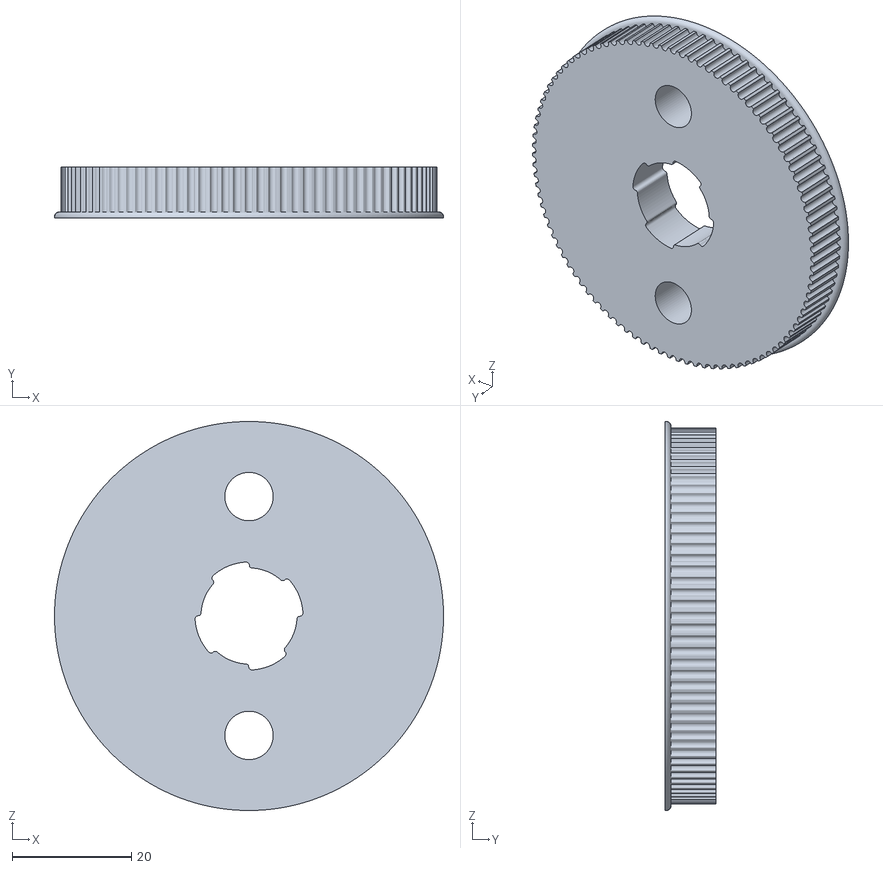
[picture p138: CAD file, 2022-07-10]
Arm Manipulator/Mekanik/STL/Pulley100.stl
65.1 x 8.50 x 65.1
