FachriMFulchan/Arm_Manipulator_7_Functions/Arm Manipulator/Mekanik/STL/Axis1Holder.stl

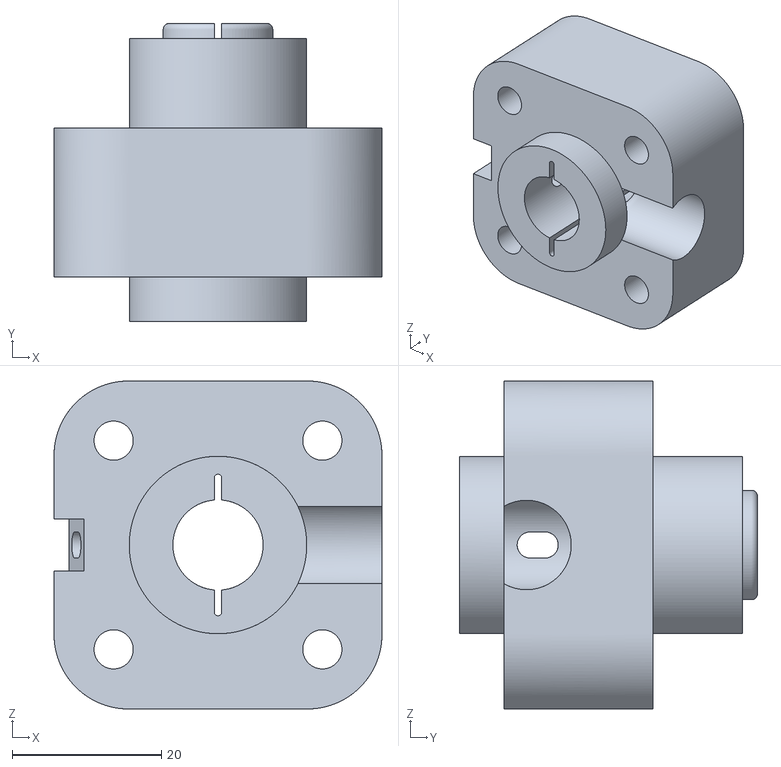
[picture p139: CAD file, 2022-07-10]
Arm Manipulator/Mekanik/STL/Axis1Holder.stl
44.0 x 40.0 x 44.0
