FachriMFulchan/Arm_Manipulator_7_Functions/Arm Manipulator/Mekanik/STL/axis6motorHolder.stl

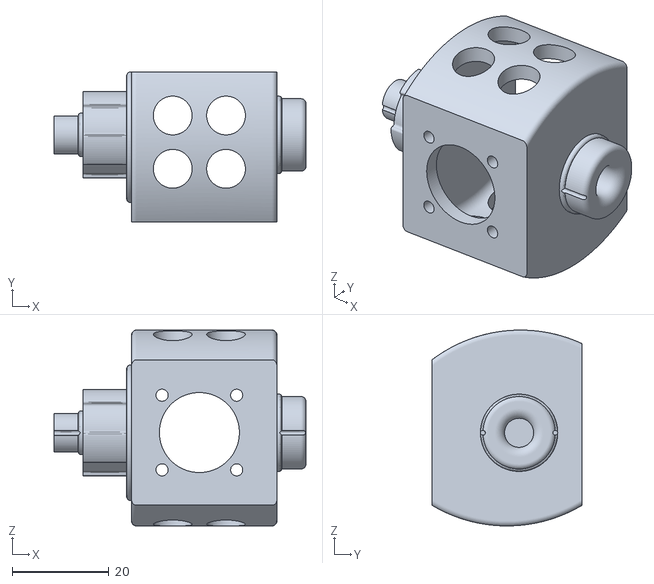
[picture p140: CAD file, 2022-07-10]
Arm Manipulator/Mekanik/STL/axis6motorHolder.stl
52.0 x 31.0 x 40.4
