FachriMFulchan/Arm_Manipulator_7_Functions/Arm Manipulator/Mekanik/STL/Axis4.stl

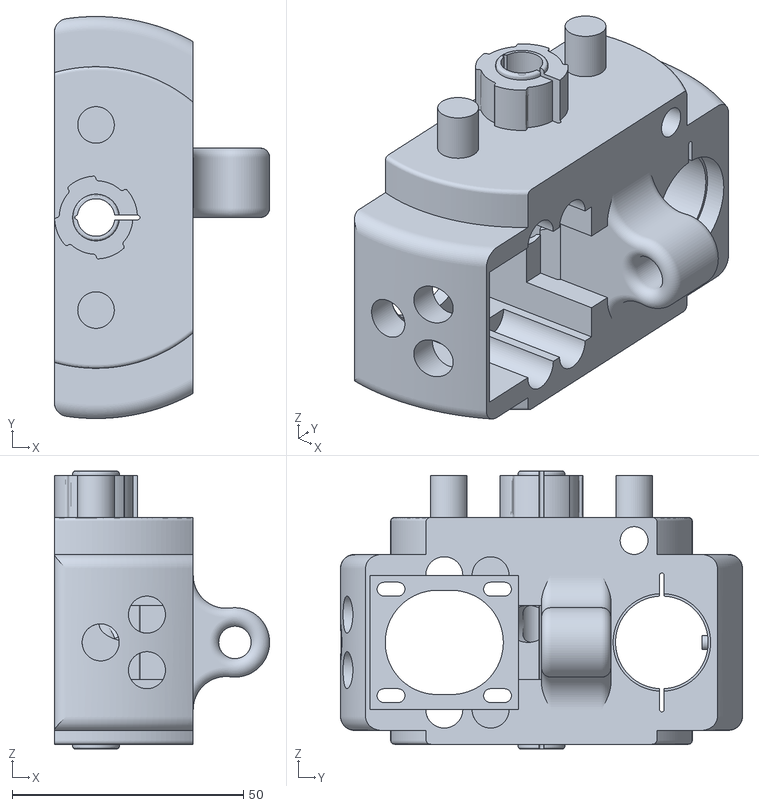
[picture p141: CAD file, 2022-07-10]
Arm Manipulator/Mekanik/STL/Axis4.stl
46.5 x 86.8 x 60.0
