FachriMFulchan/Arm_Manipulator_7_Functions/(list of files, cad)

Other CAD files:
Arm Manipulator/Mekanik/Fusion360/AxisTot1.f3z
Arm Manipulator/Mekanik/Fusion360/axis6motorHolder.f3z
Arm Manipulator/Mekanik/STL/Axis1washer.stl
Arm Manipulator/Mekanik/STL/Axis2bearingHolder (1).stl
Arm Manipulator/Mekanik/STL/Axis2washer.stl
Arm Manipulator/Mekanik/STL/Axis5screwHolder.stl
