FachriMFulchan/Arm_Manipulator_7_Functions/Arm Manipulator/Elektrik/Wiring DB-25.PNG

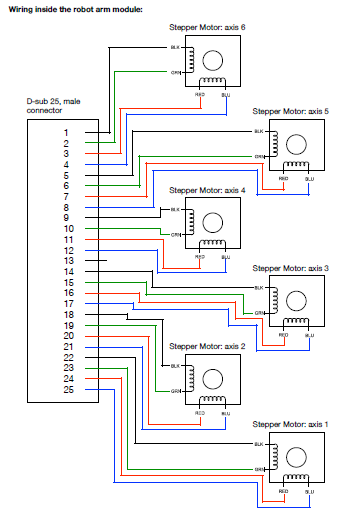
Arm Manipulator/Elektrik/Wiring DB-25.PNG
