FachriMFulchan/Arm_Manipulator_7_Functions/Master Controller/Elektrik/Wiring Master Controller.pdf

6/18/2022 6:40 PM C:\Users\dhanr\Documents\BERKAS RAIHAN\PROJECT AKHIR\Electrick Design\Base Master Controller\pcb4\pcb4\pcb master v2.brd IN | OUT IN | OUT | 1
LM2596 ( 5V CONTOLLER ) | TOGGLE | KOMDAT | LCD GRIPPER_ON_K GRIPPER_OFF_K

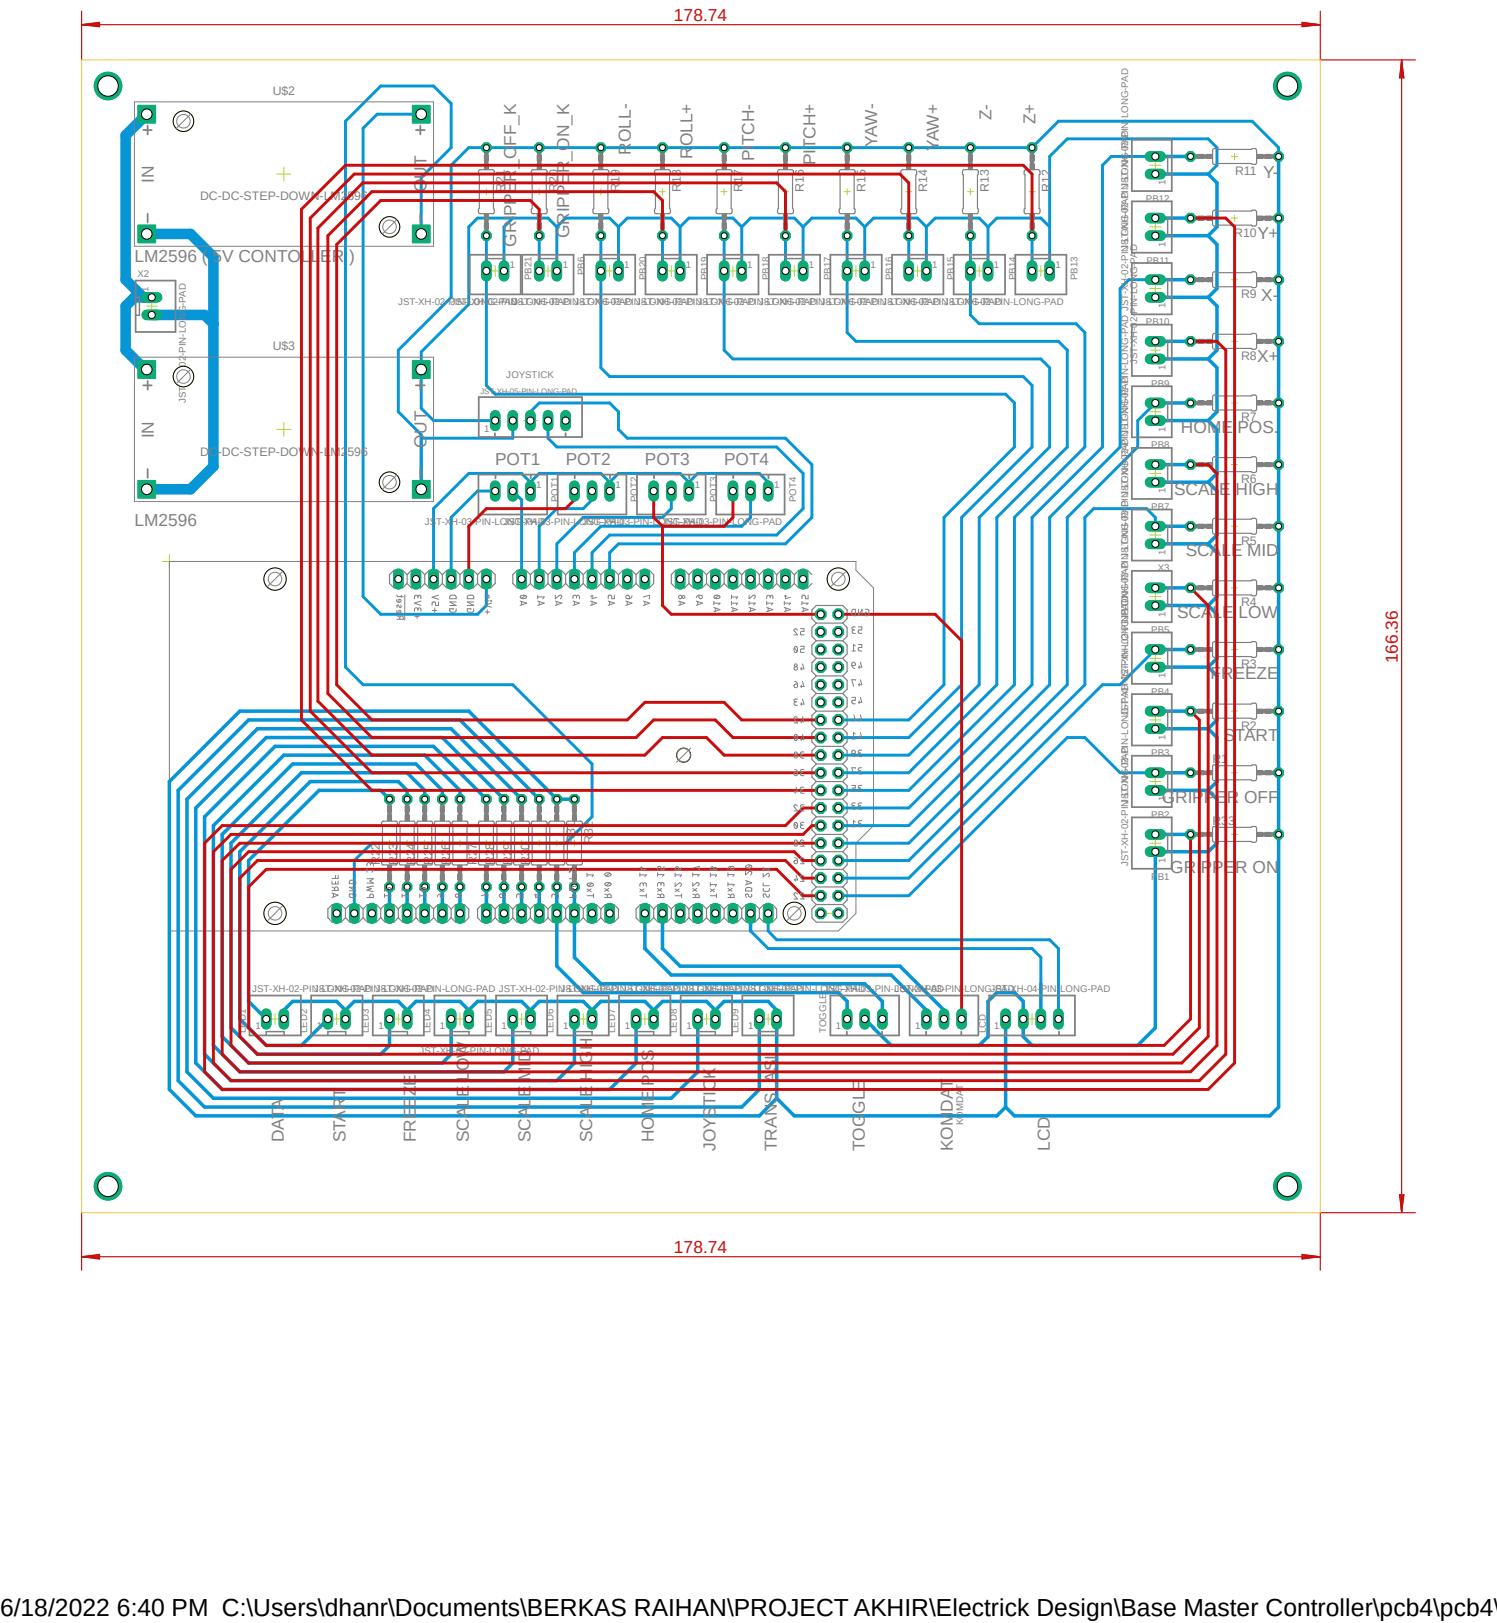
[picture p173: page 1]

JST-XH-02-PIN-LONG-PAD

JST-XH-05-PIN-LONG-PAD

JST-XH-03-PIN-LONG-PAD JST-XH-03-PIN-LONG-PAD JST-XH-03-PIN-LONG-PAD

JST-XH-03-PIN-LONG-PAD
