FachriMFulchan/Arm_Manipulator_7_Functions/Master Controller/Elektrik/EAGLE.Sch/pcb master v2.brd

## EAGLE design Master Controller/Elektrik/EAGLE.Sch/pcb master v2.brd (2022-08-14)

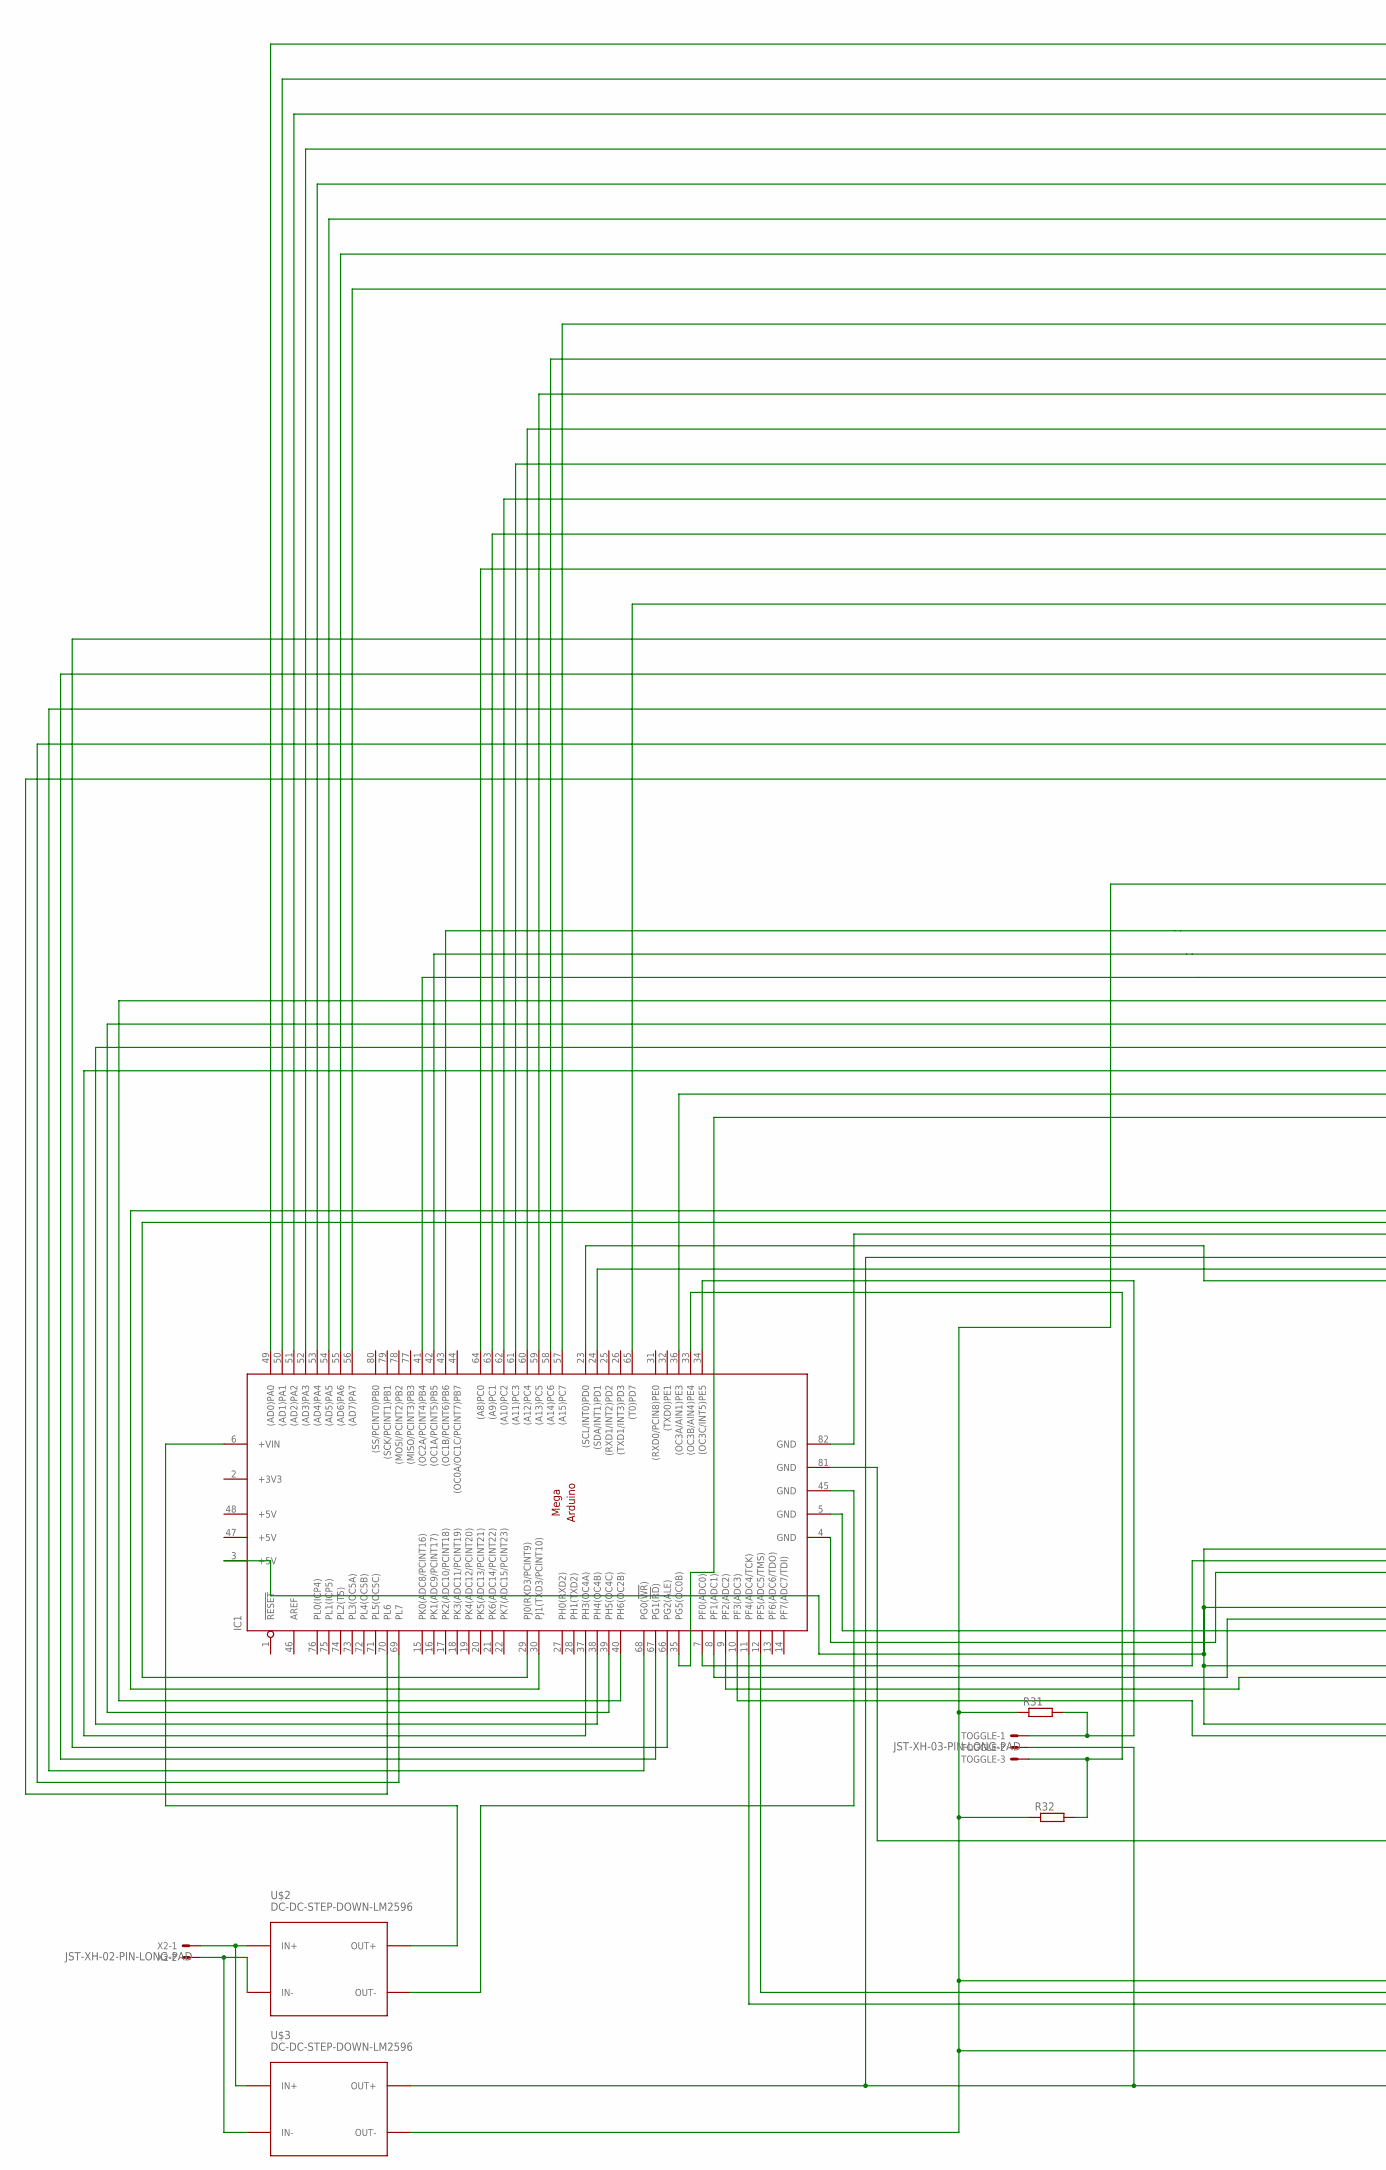
[picture p174: schematic pcb master v2.sch, part in row 1, column 1]

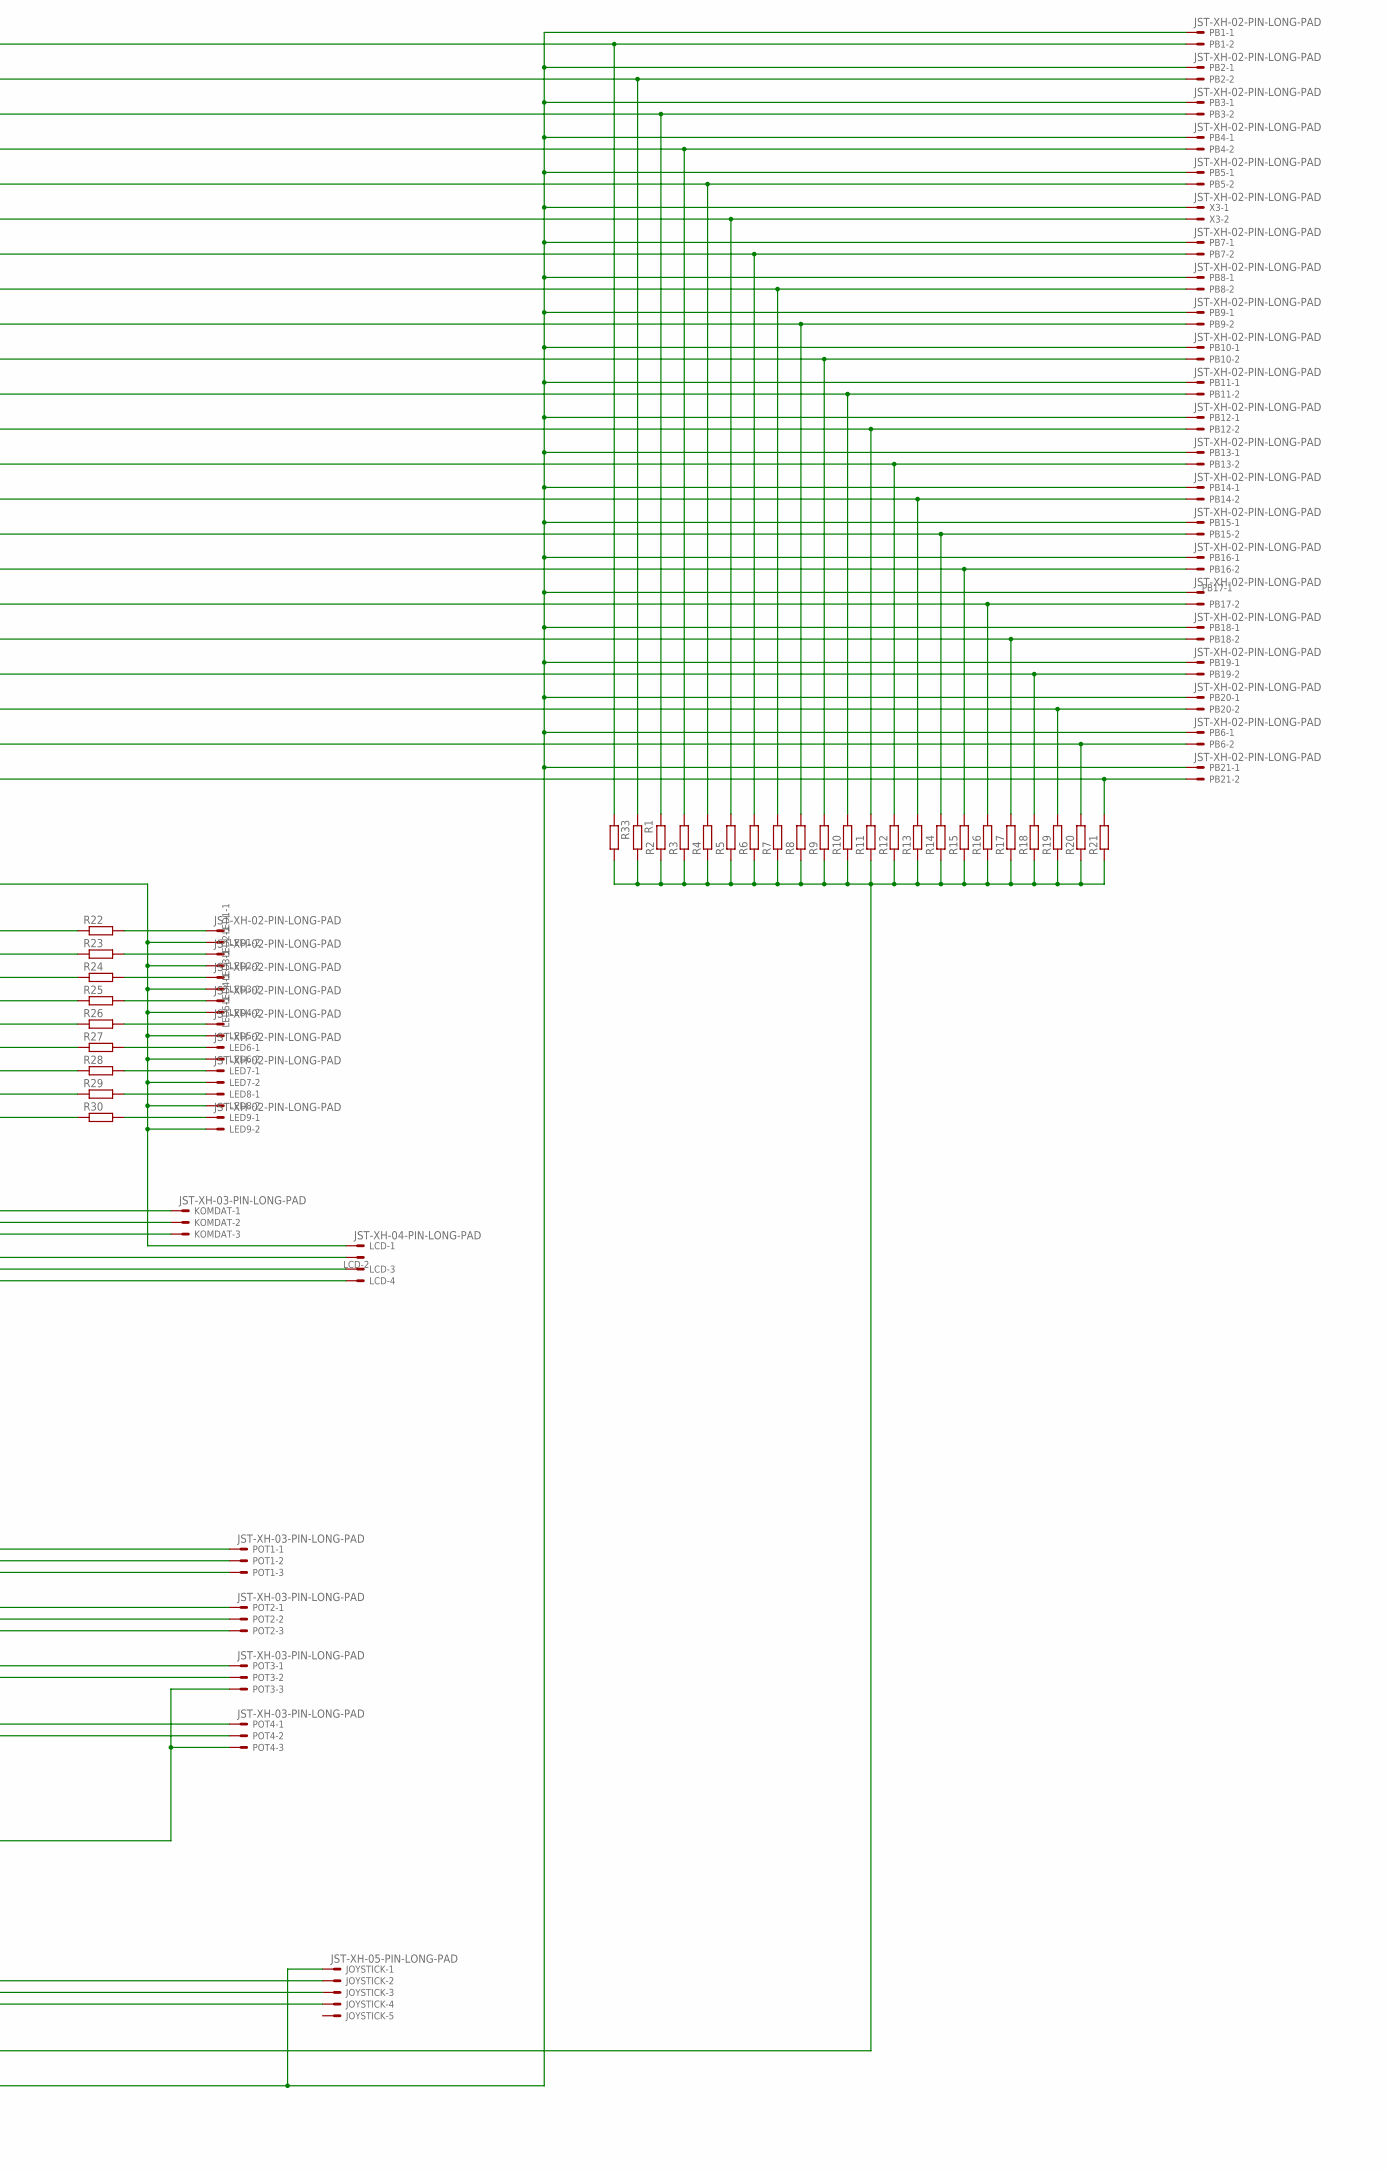
[picture p175: schematic pcb master v2.sch, part in row 1, column 2]

Parts:
IC1: MEGAARDUINO_1; MEGA_ARDUINO
JOYSTICK: JST-XH-05-PIN-LONG-PAD; JST-XH-05-PACKAGE-LONG-PAD
KOMDAT: JST-XH-03-PIN-LONG-PAD; JST-XH-03-PACKAGE-LONG-PAD
LCD: JST-XH-04-PIN-LONG-PAD; JST-XH-04-PACKAGE-LONG-PAD
LED1, LED2, LED3, LED4, LED5, LED6, LED7, LED8, LED9: JST-XH-02-PIN-LONG-PAD; JST-XH-02-PACKAGE-LONG-PAD
PB1, PB2, PB3, PB4, PB5, PB6, PB7, PB8, PB9, PB10, PB11, PB12, PB13, PB14, PB15, PB16, PB17, PB18, PB19, PB20, PB21: JST-XH-02-PIN-LONG-PAD; JST-XH-02-PACKAGE-LONG-PAD
POT1, POT2, POT3, POT4: JST-XH-03-PIN-LONG-PAD; JST-XH-03-PACKAGE-LONG-PAD
R1, R2, R3, R4, R5, R6, R7, R8, R9, R10, R11, R12, R13, R14, R15, R16, R17, R18, R19, R20, R21, R22, R23, R24, R25, R26, R27, R28, R29, R30, R31, R32, R33: R-EU_0207/12; 0207/12
TOGGLE: JST-XH-03-PIN-LONG-PAD; JST-XH-03-PACKAGE-LONG-PAD
U$2, U$3: DC-DC-STEP-DOWN-LM2596
X2, X3: JST-XH-02-PIN-LONG-PAD; JST-XH-02-PACKAGE-LONG-PAD

Connections:
+3V3: IC1.2 (+3V3)
+5V: IC1.47 (+5V), IC1.48 (+5V)
unnamed: IC1.33 ((OC3B/AIN4)PE4), R32.2, TOGGLE.3
unnamed: U$2.IN+, U$3.IN+, X2.1
unnamed: U$2.IN-, U$3.IN-, X2.2
unnamed: IC1.60 ((A12)PC4), PB12.2, R11.2
unnamed: IC1.7 (PF0(ADC0)), POT1.2
unnamed: LED1.1, R22.2
unnamed: LED2.1, R23.2
unnamed: IC1.10 (PF3(ADC3)), POT4.2
unnamed: IC1.34 ((OC3C/INT5)PE5), R31.2, TOGGLE.1
unnamed: LED3.1, R24.2
unnamed: IC1.57 ((A15)PC7), PB9.2, R8.2
unnamed: IC1.8 (PF1(ADC1)), POT2.2
unnamed: IC1.9 (PF2(ADC2)), POT3.2
unnamed: IC1.82 (GND), KOMDAT.3
unnamed: IC1.11 (PF4(ADC4/TCK)), JOYSTICK.4
unnamed: IC1.81 (GND), POT3.3, POT4.3
unnamed: LED4.1, R25.2
unnamed: IC1.24 ((SDA/INT1)PD1), LCD.3
unnamed: IC1.23 ((SCL/INT0)PD0), LCD.4
unnamed: IC1.29 (PJ0(RXD3/PCINT9)), KOMDAT.2
unnamed: IC1.70 (PL6), PB21.2, R21.2
unnamed: IC1.59 ((A13)PC5), PB11.2, R10.2
unnamed: IC1.69 (PL7), PB6.2, R20.2
unnamed: IC1.45 (GND), U$2.OUT-
unnamed: JOYSTICK.2, LCD.1, LED1.2, LED2.2, LED3.2, LED4.2, LED5.2, LED6.2, LED7.2, LED8.2, LED9.2, R1.2, R2.1, R3.1, R4.1, R5.1, R6.1, R7.1, R8.1, R9.1, R10.1, R11.1, R12.1, R13.1, R14.1, R15.1, R16.1, R17.1, R18.1, R19.1, R20.1, R21.1, R31.1, R32.1, R33.2, U$3.OUT-
unnamed: LED7.1, R28.2
unnamed: IC1.6 (+VIN), U$2.OUT+
unnamed: IC1.65 ((T0)PD7), PB17.2, R16.2
unnamed: IC1.3 (+5V), POT1.1, POT2.1, POT3.1, POT4.1
unnamed: IC1.64 ((A8)PC0), PB16.2, R15.2
unnamed: IC1.30 (PJ1(TXD3/PCINT10)), KOMDAT.1
unnamed: IC1.66 (PG2(ALE)), PB18.2, R17.2
unnamed: IC1.12 (PF5(ADC5/TMS)), JOYSTICK.3
unnamed: IC1.54 ((AD5)PA5), R5.2, X3.2
unnamed: IC1.58 ((A14)PC6), PB10.2, R9.2
unnamed: IC1.49 ((AD0)PA0), PB1.2, R33.1
unnamed: IC1.68 (PG0(!WR!)), PB20.2, R19.2
unnamed: IC1.50 ((AD1)PA1), PB2.2, R1.1
unnamed: IC1.52 ((AD3)PA3), PB4.2, R3.2
unnamed: LED5.1, R26.2
unnamed: LED6.1, R27.2
unnamed: LED8.1, R29.2
unnamed: LED9.1, R30.2
unnamed: IC1.35 (PG5(OC0B)), R30.1
unnamed: IC1.36 ((OC3A/AIN1)PE3), R29.1
unnamed: IC1.37 (PH3(OC4A)), R28.1
unnamed: IC1.38 (PH4(OC4B)), R27.1
unnamed: IC1.39 (PH5(OC4C)), R26.1
unnamed: IC1.40 (PH6(OC2B)), R25.1
unnamed: IC1.41 ((OC2A/PCINT4)PB4), R24.1
unnamed: IC1.42 ((OC1A/PCINT5)PB5), R23.1
unnamed: IC1.43 ((OC1B/PCINT6)PB6), R22.1
unnamed: IC1.62 ((A10)PC2), PB14.2, R13.2
unnamed: IC1.56 ((AD7)PA7), PB8.2, R7.2
unnamed: IC1.4 (GND), POT1.3
unnamed: IC1.5 (GND), POT2.3
unnamed: IC1.61 ((A11)PC3), PB13.2, R12.2
unnamed: IC1.63 ((A9)PC1), PB15.2, R14.2
unnamed: IC1.67 (PG1(!RD!)), PB19.2, R18.2
unnamed: JOYSTICK.1, LCD.2, PB1.1, PB2.1, PB3.1, PB4.1, PB5.1, PB6.1, PB7.1, PB8.1, PB9.1, PB10.1, PB11.1, PB12.1, PB13.1, PB14.1, PB15.1, PB16.1, PB17.1, PB18.1, PB19.1, PB20.1, PB21.1, TOGGLE.2, U$3.OUT+, X3.1
unnamed: IC1.51 ((AD2)PA2), PB3.2, R2.2
unnamed: IC1.53 ((AD4)PA4), PB5.2, R4.2
unnamed: IC1.55 ((AD6)PA6), PB7.2, R6.2

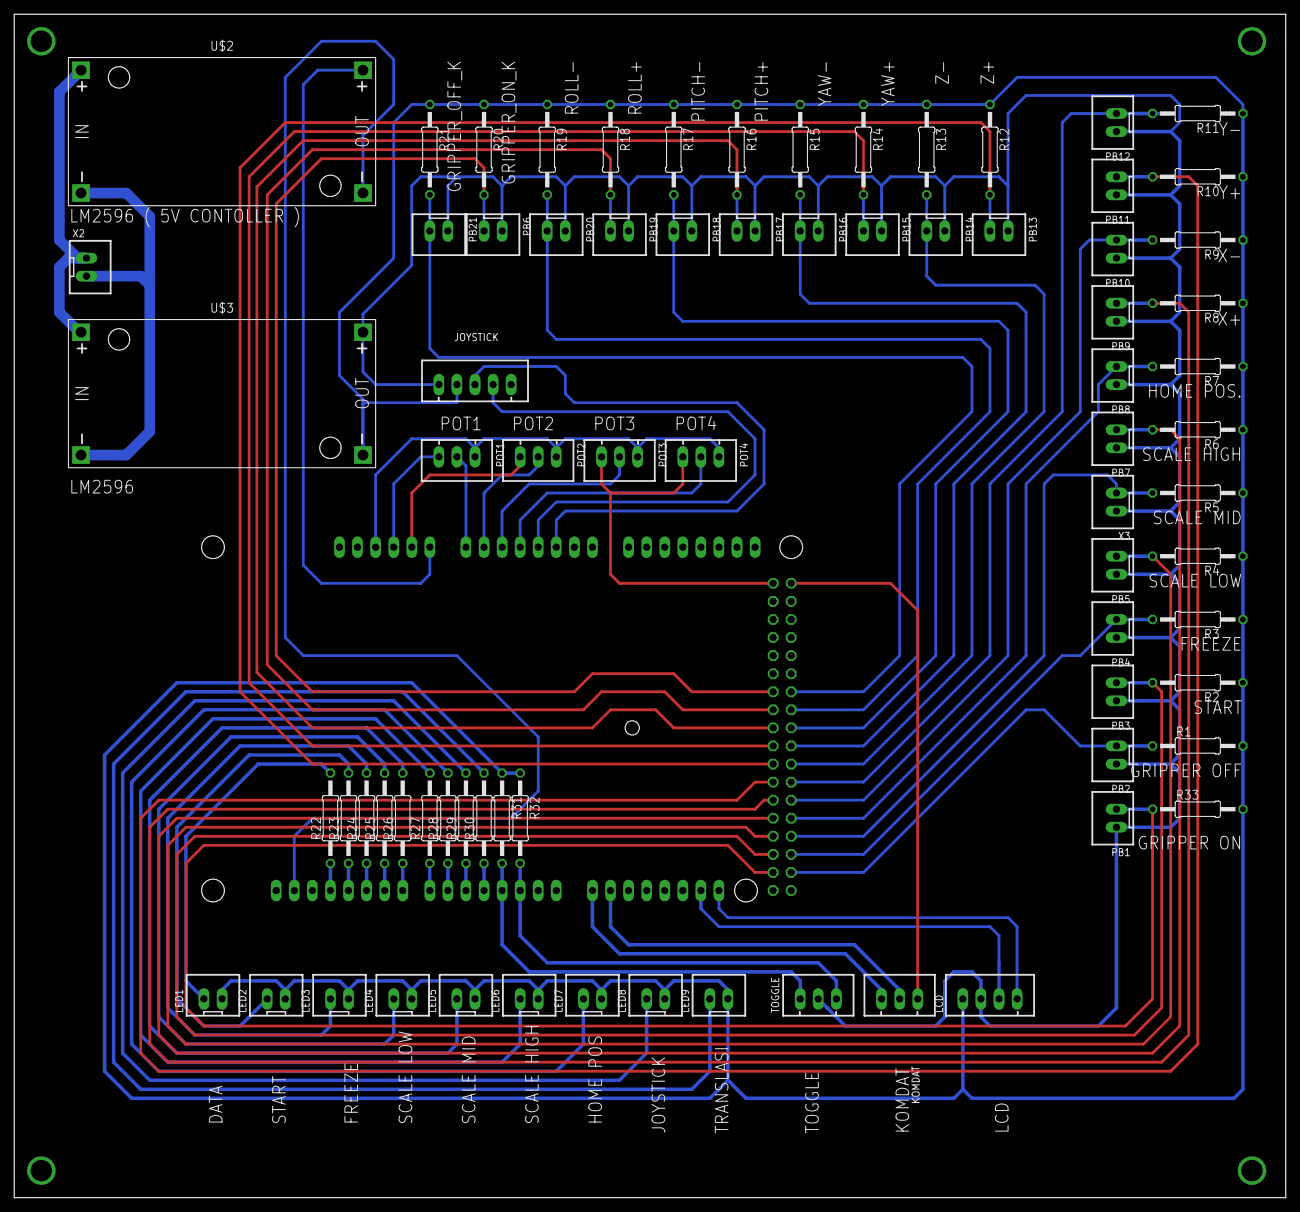
[picture p176: board pcb master v2.brd from above]

Board: 2 copper layers, 178.7 x 166.4 mm, 76 parts (1 on the bottom side), 64 nets.
